FelipeSorrilha/Desenvolvimento-de-uma-plataforma-experimental/README.md

# Desenvolvimento-de-uma-plataforma-experimental
 Desenvolvimento de uma plataforma experimental para pesquisa em controle de sistemas aeroespaciais de asa rotativa utilizando impressão 3D
