FelipeSorrilha/Desenvolvimento-de-uma-plataforma-experimental/3D models/readme.md

# Modelos 3D

## helice

### Hélice que poderá ser utilizada junto com o Motor DC.

Inicialmente, será testado essa hélice com 2 pás.

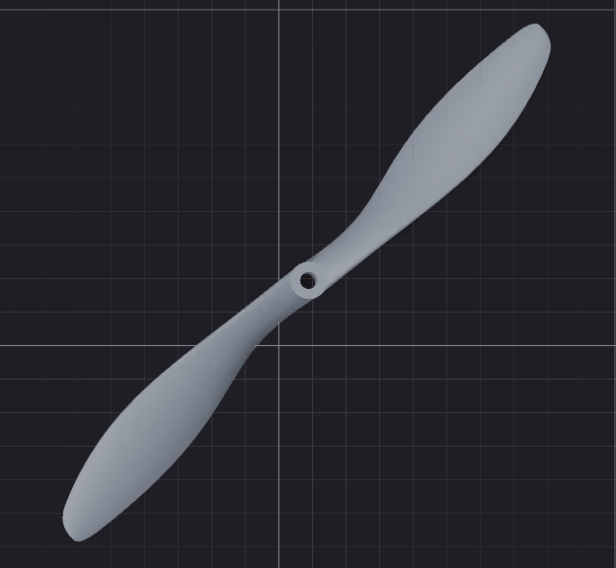
[picture p2: 3D models/imagens/helice.png]


---

## suporte-motor-drone

### Suporte onde o Motor DC 555-2990 vai ser encaixado.

O suporte foi projetado com uma abertura lateral e furos para os parafusos. Assim, o motor pode ser encaixado com facilidade, após apertar os parafusos, o suporte segura o motor.

Do outro lado, 5 furos foram posicionados para parafusar na peça encaixe-arm-motordrone. Os 5 parafusos em forma de cruz permitem que o suporte pode ser colocado tanto na vertical quanto na horizontal.

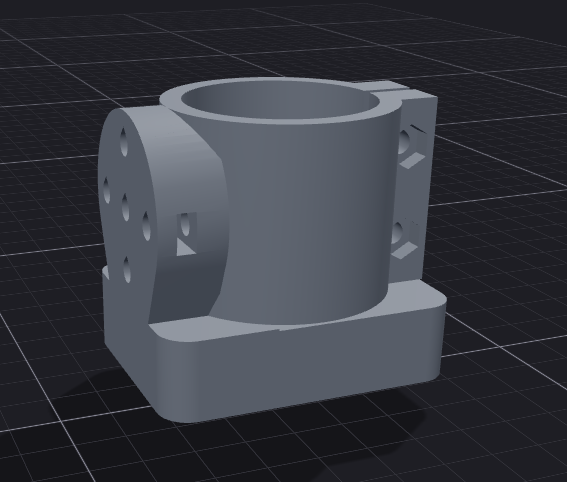
[picture p3: 3D models/imagens/suporte-motor-drone1.png]
Suporte motor drone


Em baixo do suporte, uma abertura foi feita para encaixar o encoder AS5047p.

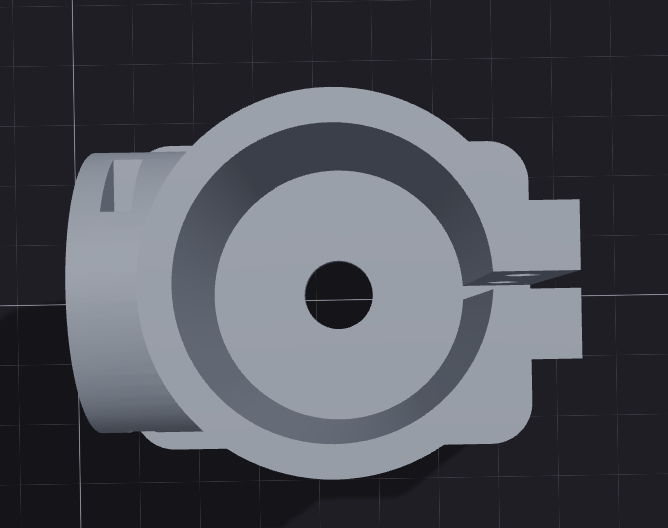
[picture p4: 3D models/imagens/suporte-motor-drone2.png]
Vista de cima


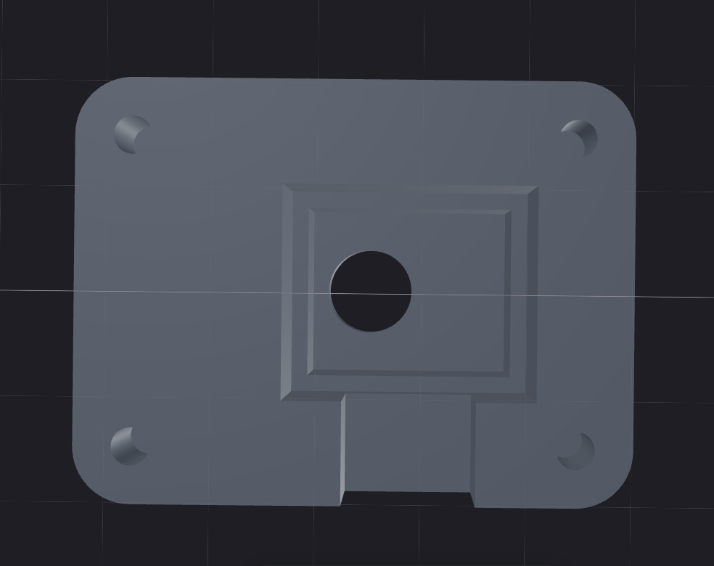
[picture p5: 3D models/imagens/suporte-motor-drone3.png]
Vista de baixo


---

## tampa-motor-drone

### Tampa para fechar e fixar o encoder em baixo do suporte do motor.

Essa tampa foi projetada para levantar um pouco a altura do encoder, deixando um pequeno espaço para os fios passarem.

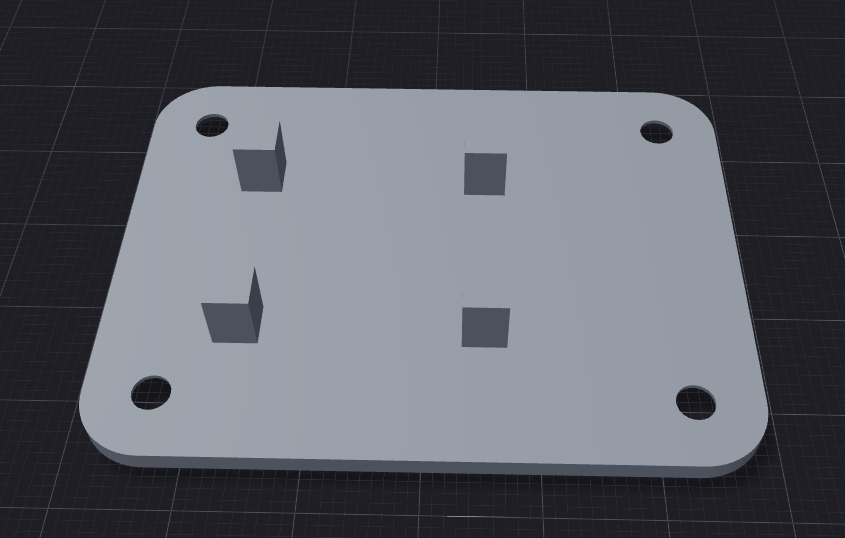
[picture p6: 3D models/imagens/tampa-motor-drone.png]
Tampa da peça anterior


---

## encaixe-arm-motordrone

### Encaixe que fixa o suporte do motor ao braço

Esse encaixe possui 3 furos que serão utilizados para fixar as duas peças.

Na horizontal, os outros 2 furos são utilizados para fixar o encaixe à peça arm.

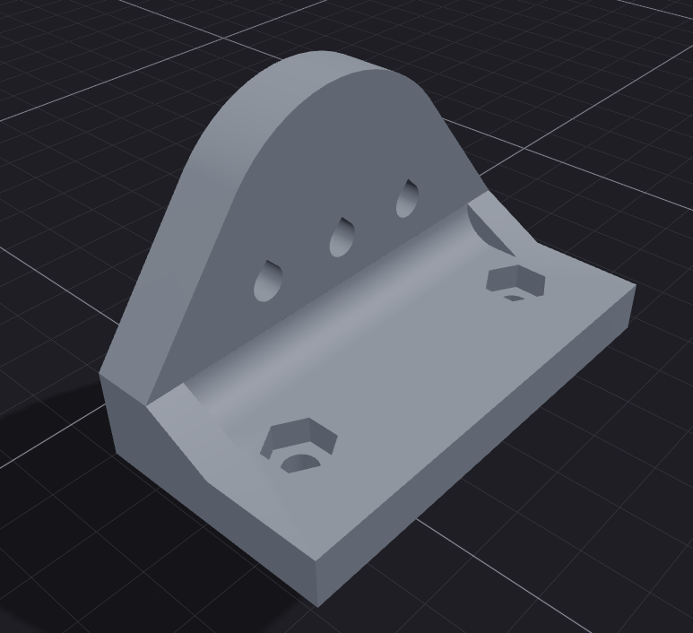
[picture p7: 3D models/imagens/encaixe-arm-motordrone.png]
Encaixe-arm-motordrone


---

## arm

### Braço que fixa a junção do suporte que segura o motor ao hub central.

Esse braço possui duas extremidades. A primeira com 2 furos é utilizada para fixar a peça encaixe-arm-motordrone, enquanto a outra extremidade com 4 furos é utilizada para fixar o braço ao hub central.

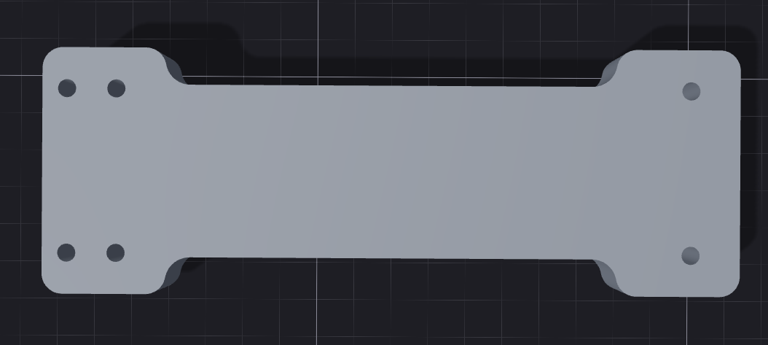
[picture p8: 3D models/imagens/arm.png]
Arm visto de cima


---

## central-hub

### Hub que fica no centro, tem espaço para o acelerômetro e segura os dois braços.

O furo no meio será utilizado para encaixar o eixo que será fixo e girará junto com os rolamentos. Enquanto isso, os 4 furos de cada lado são utilizados para fixar os braços

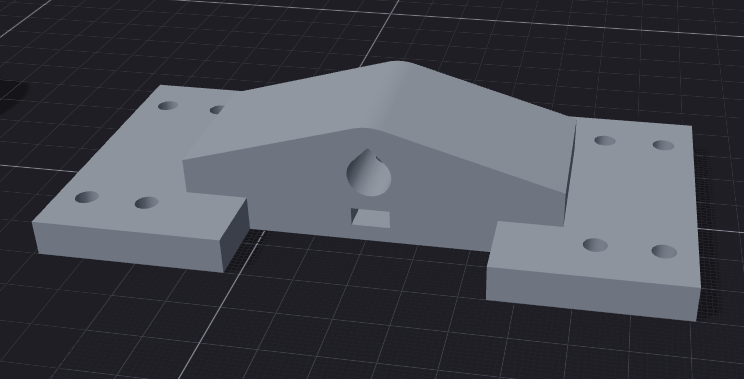
[picture p9: 3D models/imagens/central-hub1.png]
Hub central


Em baixo, há um espaço para encaixar o acelerômetro. 

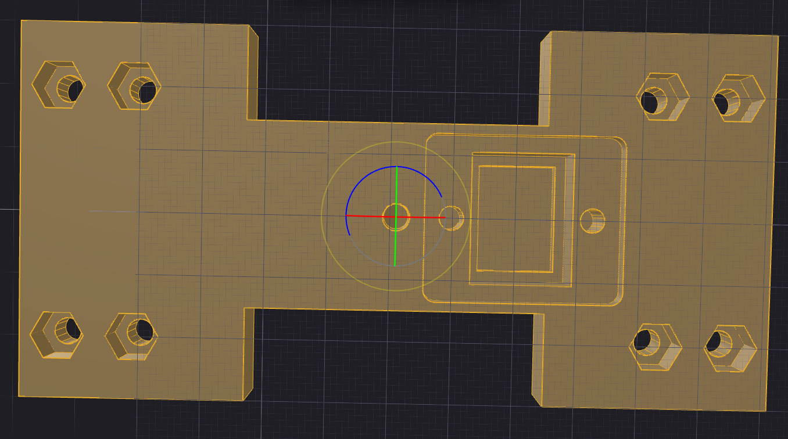
[picture p10: 3D models/imagens/central-hub2.png]
Vista de baixo com outra coloração para facilitar a visualização


---

## tampaCentralHub

### Tampa que fixa o acelerômetro em baixo do hub central.

Um pequeno suporte eleva a altura do acelerômetro. Alguns furos foram feitos para a passagem da fiação.

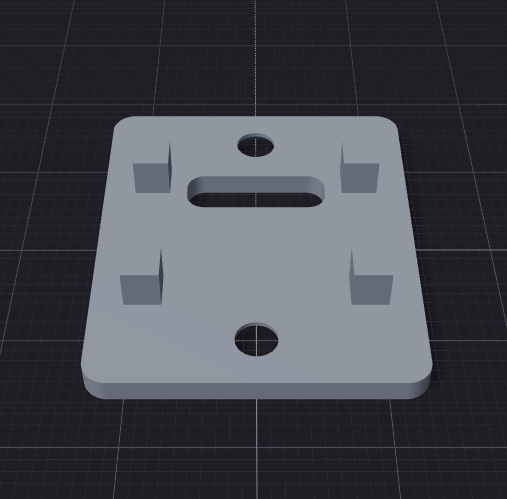
[picture p11: 3D models/imagens/tampaCentralHub.png]
Tampa do Hub Central


---

## Junção da primeira parte

### Formação da primeira parte, "gangorra".

Juntando as peças - suporte-motor-drone (2x), encaixe-arm-motordrone (2x), arm (2x) e central-hub - é possível visualizar a primeira parte da plataforma, que funciona como uma gangorra.

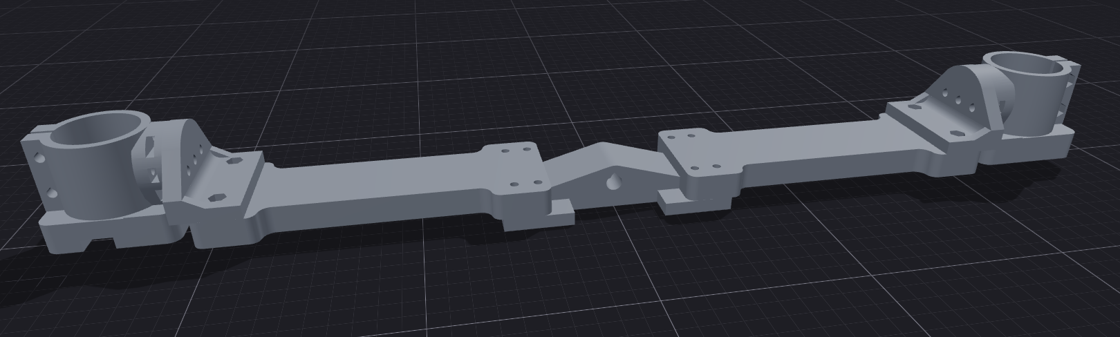
[picture p12: 3D models/imagens/encaixes1.png]


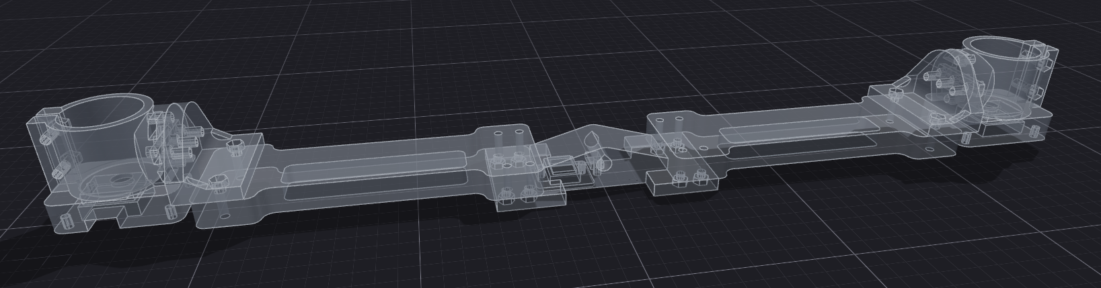
[picture p13: 3D models/imagens/encaixes2.png]
Outra visualização onde é possível ver os furos ligados


---

## novoTopo

### Topo do projeto, onde ficam os rolamentos e o eixo que segura o hub central.

De cada lado, um rolamento 608 será encaixado, enquanto um eixo irá atravessar eles e o hub central.

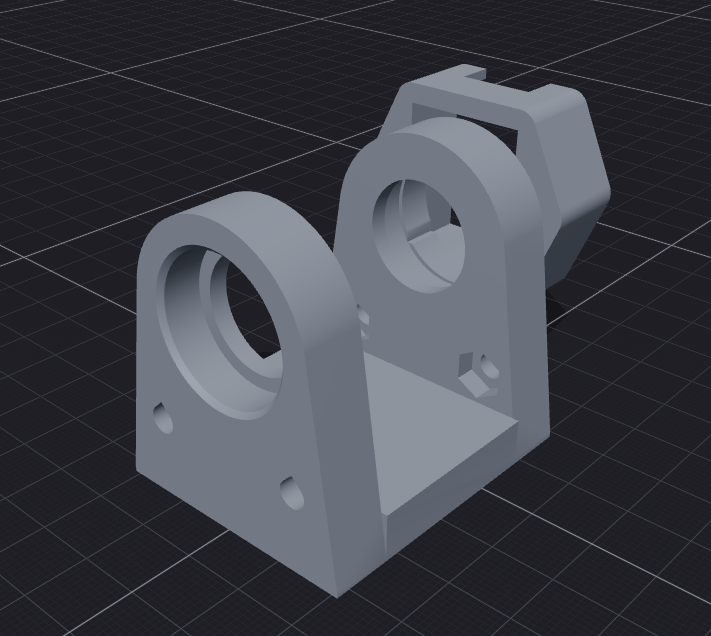
[picture p14: 3D models/imagens/novotopo1.png]


Em um dos lados, um encoder AS5047P será utilizado para medir a inclinação da "gangorra".

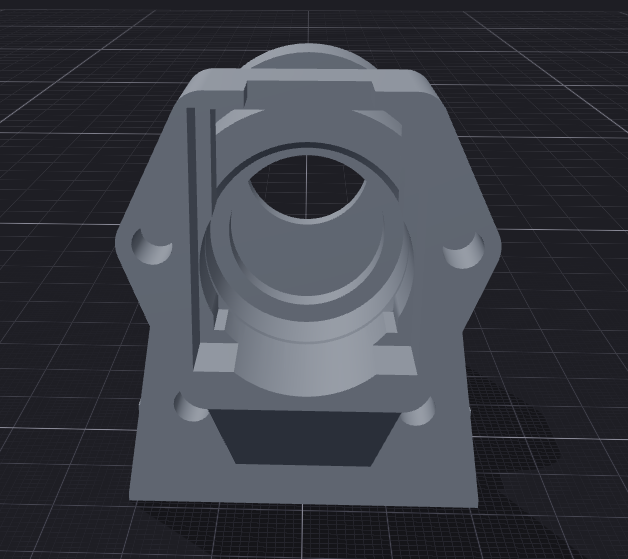
[picture p15: 3D models/imagens/novotopo2.png]


---

## tampaNovotopo

### Tampa que segura o encoder do novoTopo.

Uma tampa com pequenos suportes para deixar espaço para fiação irá prender o encoder AS5047p na lateral do novoTopo

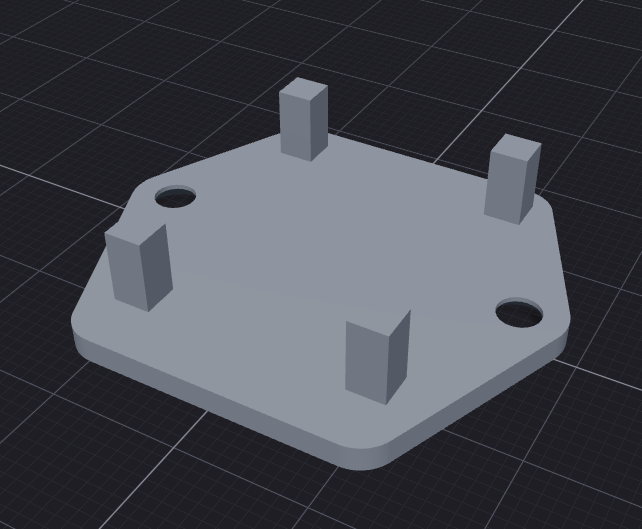
[picture p16: 3D models/imagens/tampaNovoTopo.png]


---

## eixoRolamentosEnconders

### Eixo que irá atravessar as peças.

Esse eixo girará junto com os rolamentos e será fixado no hub central. Em uma das extremidades, um imã será fixado para que o encoder possa medir a inclinação.

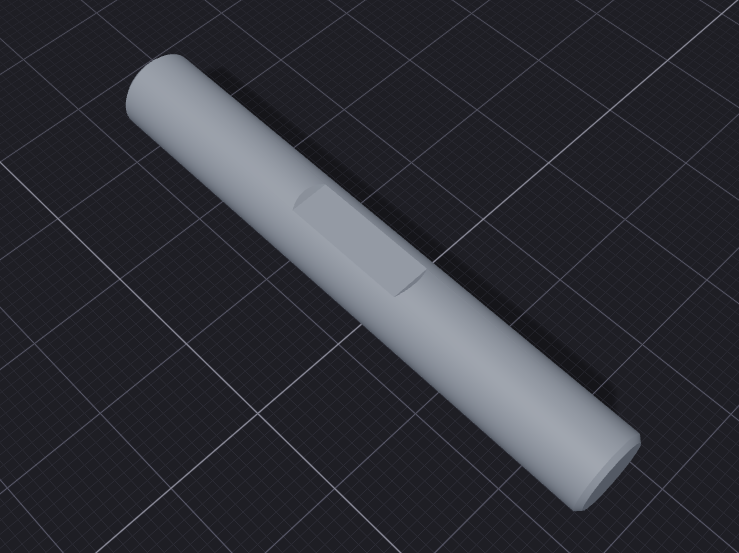
[picture p17: 3D models/imagens/eixoRolamentosEncoders.png]


---

## Y1 e Y2

### Duas peças que formam uma estrutura em formato de "Y".

Essas peças foram modeladas para que possam ser encaixadas e parafusadas.

Ela foi separada em duas peças para que fosse possível passar a fiação enquanto mantem esse formato de "Y". 

No topo dela, o novoTopo será fixado com parafusos. Em baixo, uma pequena parede será utilizada para limitar a rotação no plano XY. Um pequeno furo no centro será utilizado para fixar essa estrutura no encoder yaw que fica dentro da caixa.

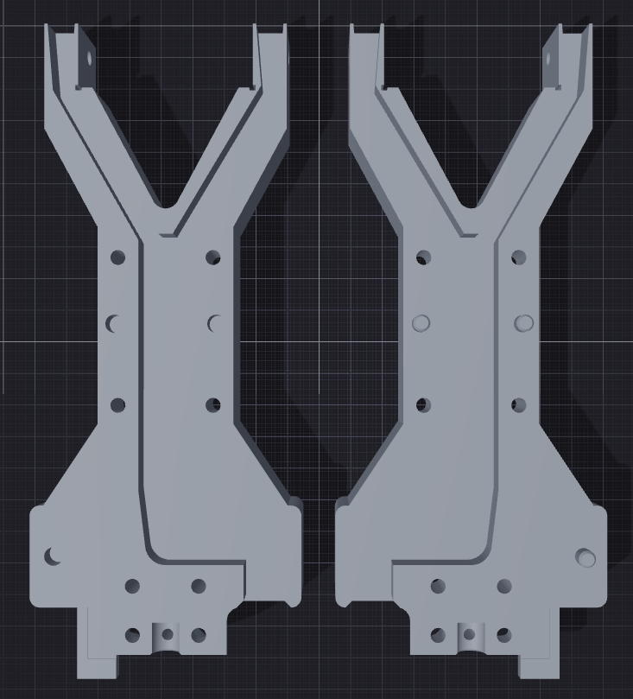
[picture p18: 3D models/imagens/y1ey2_1.png]


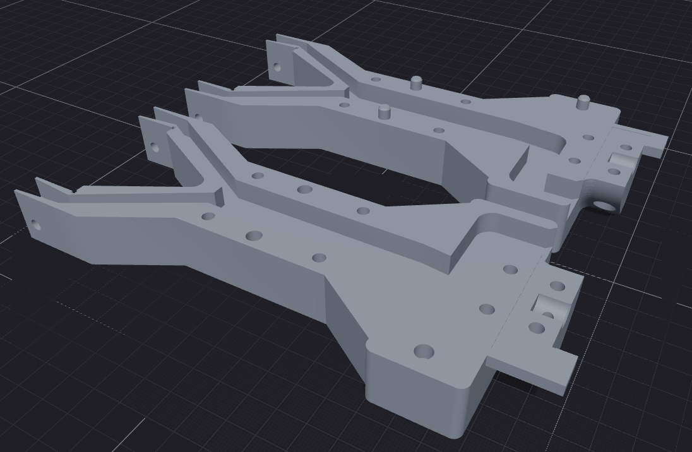
[picture p19: 3D models/imagens/y1ey2_2.png]


---

## Junção da segunda parte

### Formação da segunda parte em formato de "Y".

Juntando Y1, Y2, novoTopo e o eixoRolamentosEncoders, formamos a estrutura que sustentará a "gangorra", permitirá que ela possa se inclinar e poder girar 120° graus

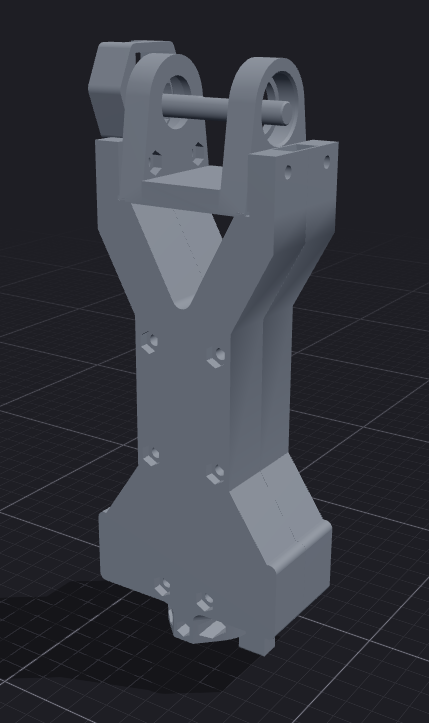
[picture p20: 3D models/imagens/encaixes3.png]


---

## Junção da primeira parte com a segunda

### Formação de tudo que ficará em cima da caixa.

Juntando todas essas peças, temos tudo que ficará em cima da caixa, que serve como base.

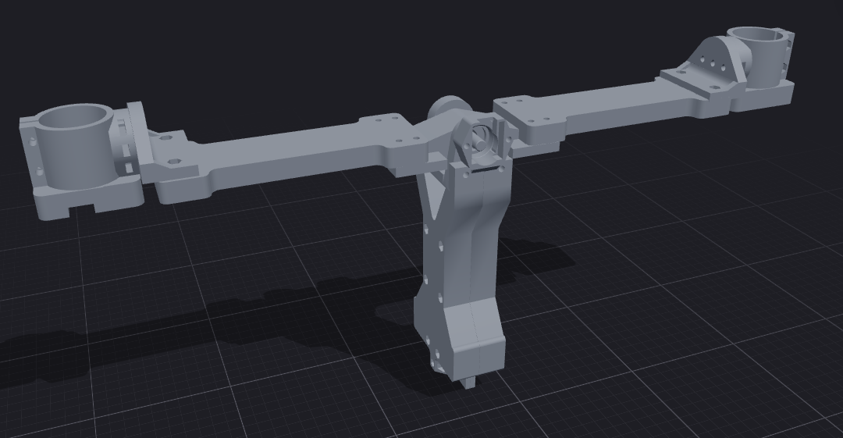
[picture p21: 3D models/imagens/parte1+2.png]


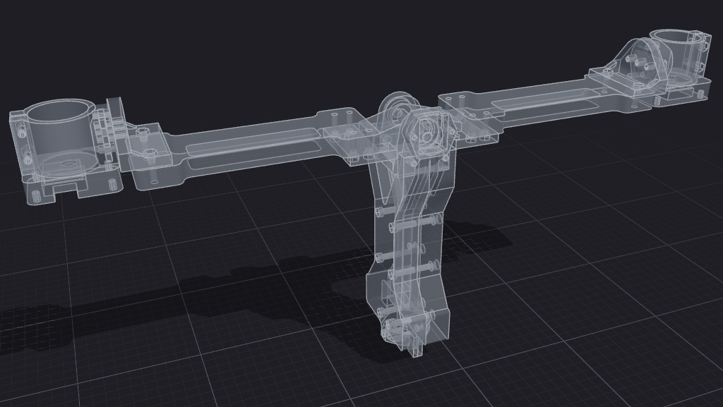
[picture p22: 3D models/imagens/parte1+2_2.png]


Do jeito que foi projetado, a "gangorra" (primeira parte) tem aproximadamente ±51,5° graus de liberdade, encostando no "Y" no máximo.

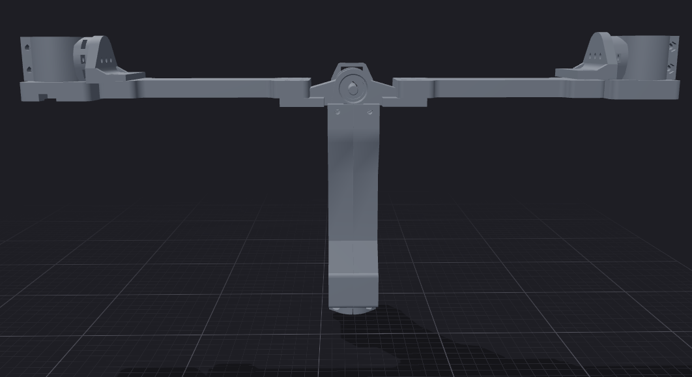
[picture p23: 3D models/imagens/parte1+2_3.png]


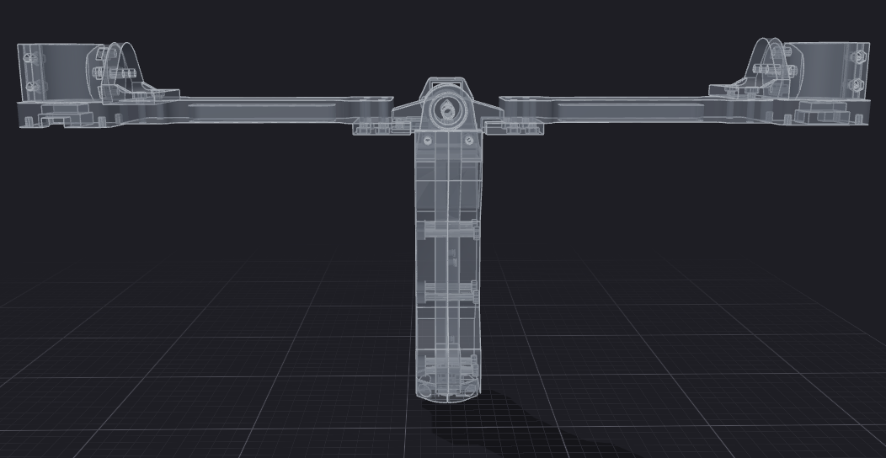
[picture p24: 3D models/imagens/parte1+2_4.png]


---

## caixav3

### Caixa onde fica o encoder de Yaw e microcontrolador.

A caixa (de ponta cabeça na foto) foi projetada para que o "Y" possa rotacionar aproximadamente 120 graus, enquanto deixa outros 120 graus para passagem de fiação.

No Centro, um cilindro com furos foi posicionado para poder fixar a peça RolamentoOldham-yaw. Peça qual conterá todo o dispositivo que permite o Y rotacionar.

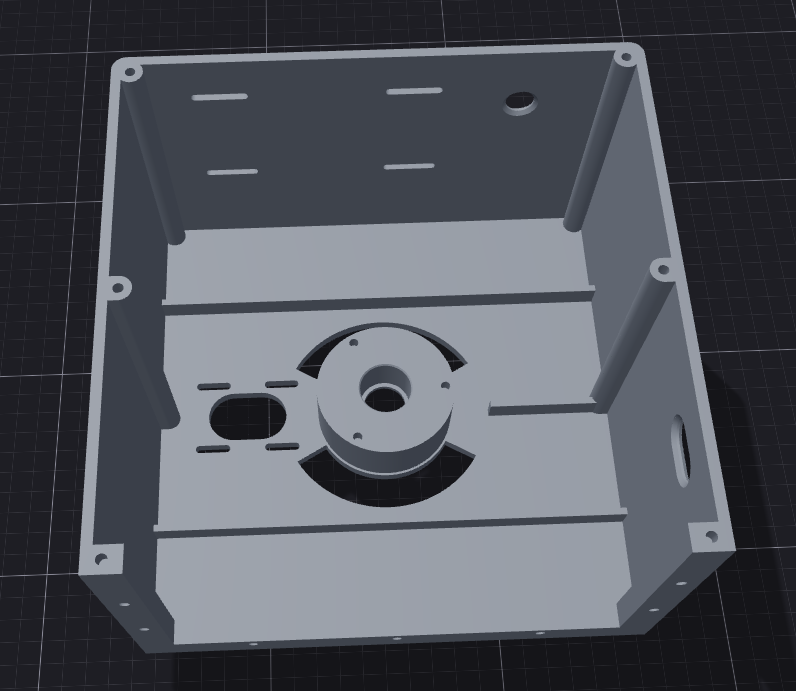
[picture p25: 3D models/imagens/caixav3_1.png]


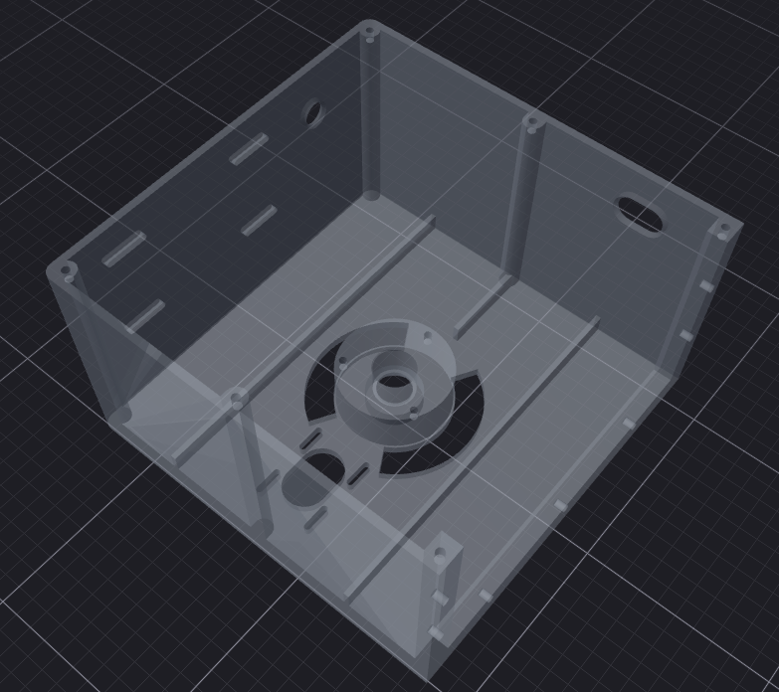
[picture p26: 3D models/imagens/caixav3_2.png]


Alguns furos foram feitos nas paredes para possibilitar a passagem de ar e passagem de cabos de alimentação.

---

## tampa-solo

### Tampa da caixa.

Uma tampa que, na verdade, fica em contato com o solo.

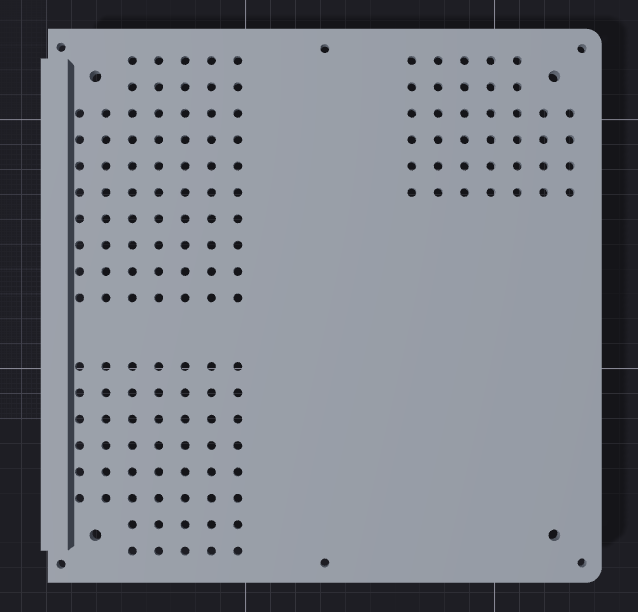
[picture p27: 3D models/imagens/tampa-solo.png]


---

## parede-removivel

### Parede da caixa.

Uma parede parafusada que pode ser retirada quando for preciso mudar algo no circuito. Para atualizar o microcontrolador (fazer upload de um novo código), basta passar o cabo por um dos furos da caixa.

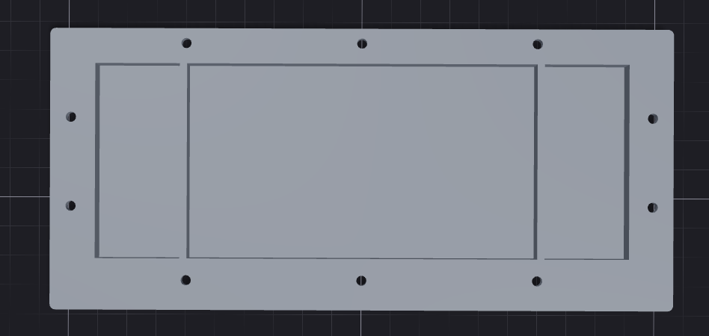
[picture p28: 3D models/imagens/paredeRemovivel.png]


---

## oldham1, oldham2, entreOsOldham

### Peças baseadas na junta oldham.

Três peças que foram baseadas na junta oldham. 

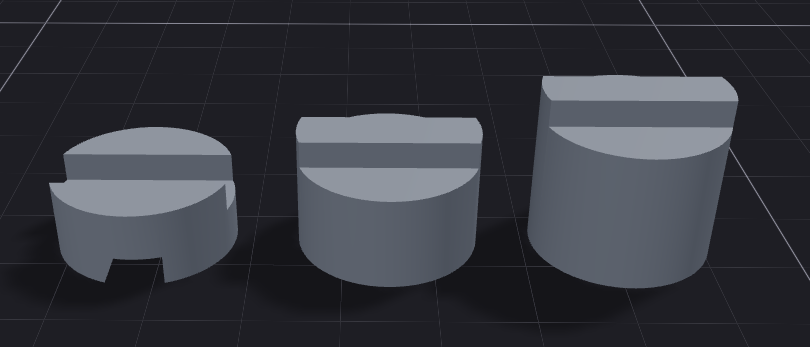
[picture p29: 3D models/imagens/oldham1.png]


A ideia é que um rolamento posicionado acima do encaixe faça toda a estrutura girar, que irá girar o eixo do encoder de Yaw posicionado em baixo.

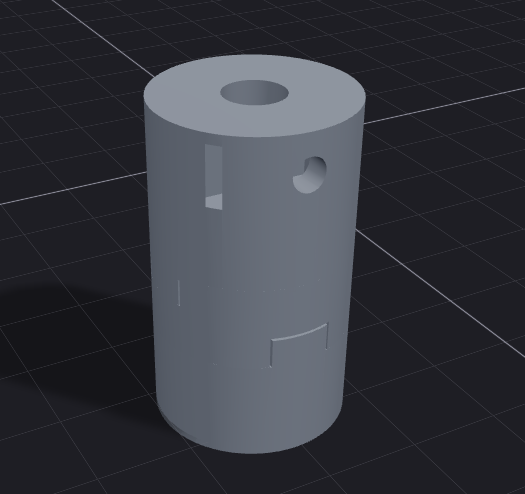
[picture p30: 3D models/imagens/oldhamjunto1.png]


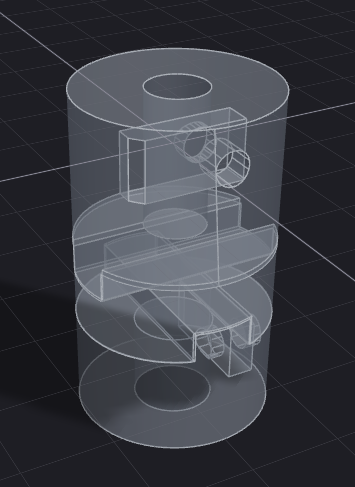
[picture p31: 3D models/imagens/oldhamjunto2.png]


---

## rolamentoToY

### Peça que gira o oldham.

É uma peça que é fixada no "Y", quando o Y gira, ela gira e movimento a junta oldham, que gira o encoder da base.

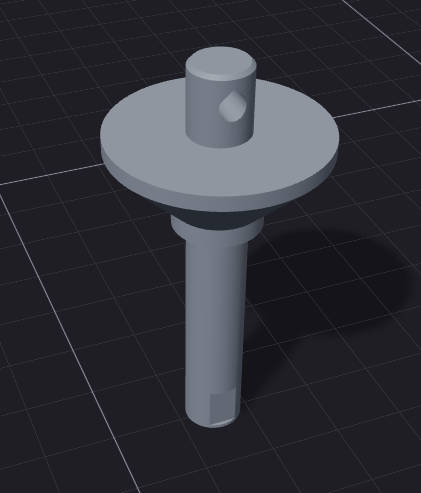
[picture p32: 3D models/imagens/rolamentoToY.png]


---

## RolamentoOldham-yaw

### Peça que é fixada no centro da caixa.

Dentro dessa peça, toda a junta oldham e o rolamento 608 serão posicionados para girar.

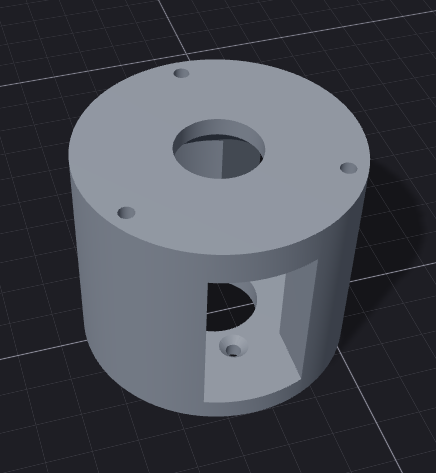
[picture p33: 3D models/imagens/rolamentooldham-yaw_1.png]


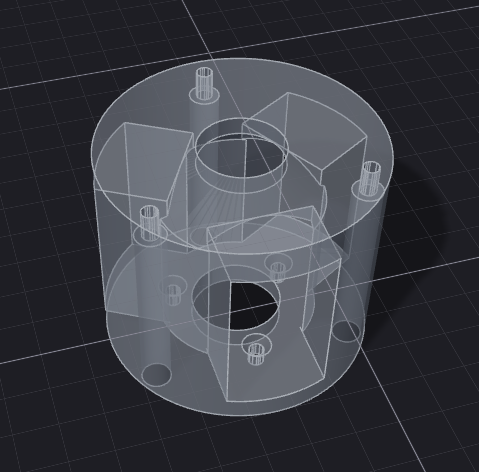
[picture p34: 3D models/imagens/rolamentooldham-yaw_2.png]


--- 

## Junção da terceira parte

### Encaixe da junta oldham na caixa.

Juntando a junta olhdam, RolamentoOldHam-yaw e rolamentoToY, temos a terceira parte que é encaixada na caixa.

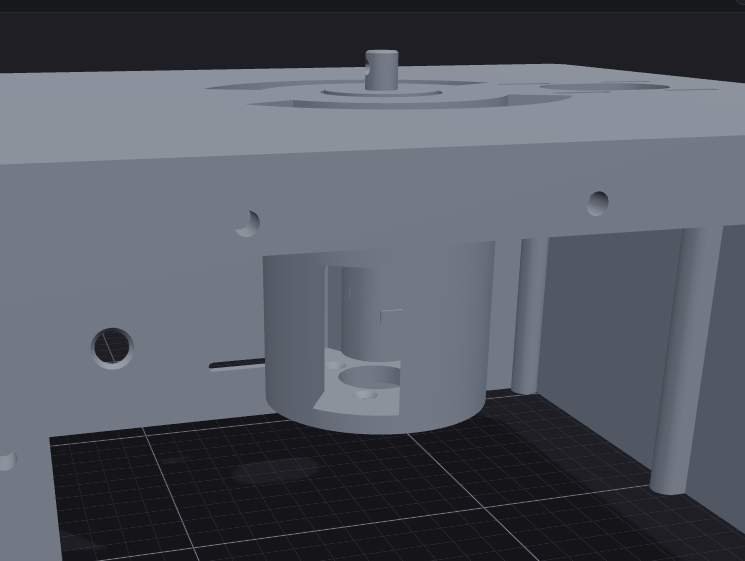
[picture p35: 3D models/imagens/oldhamInstaladoNaCaixa.png]


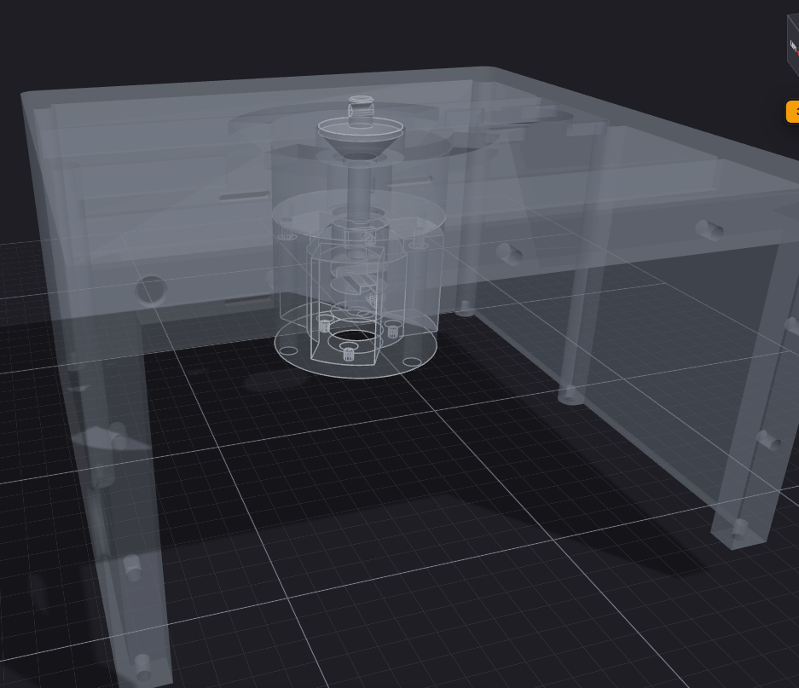
[picture p36: 3D models/imagens/oldhamInstaladoNaCaixa2.png]


--- 

## Junção da quarta parte

### Encaixe do Y na caixa, parede e tampa.

Fixando a tampa e parede removível, temos a caixa completa (na imagem, o motor em baixo é meramente ilustrativo)

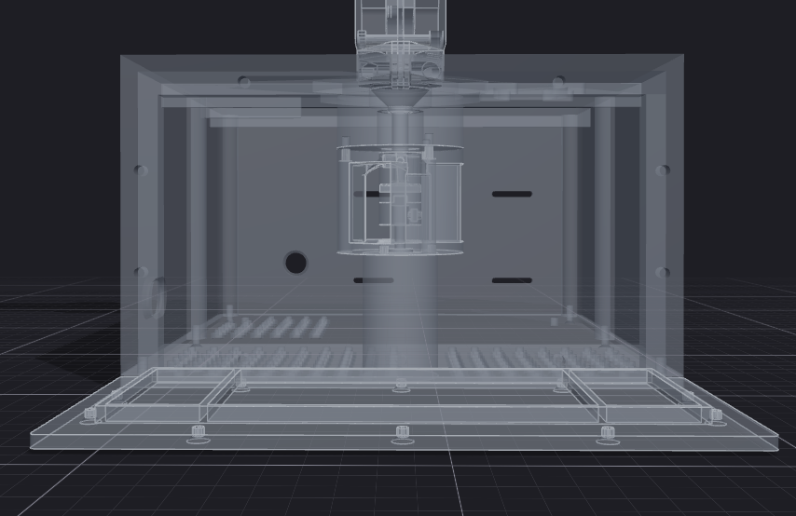
[picture p37: 3D models/imagens/montagemCompleta1_1.png]


Em cima da caixa, a parte 2 completa (Y) pode ser encaixada.

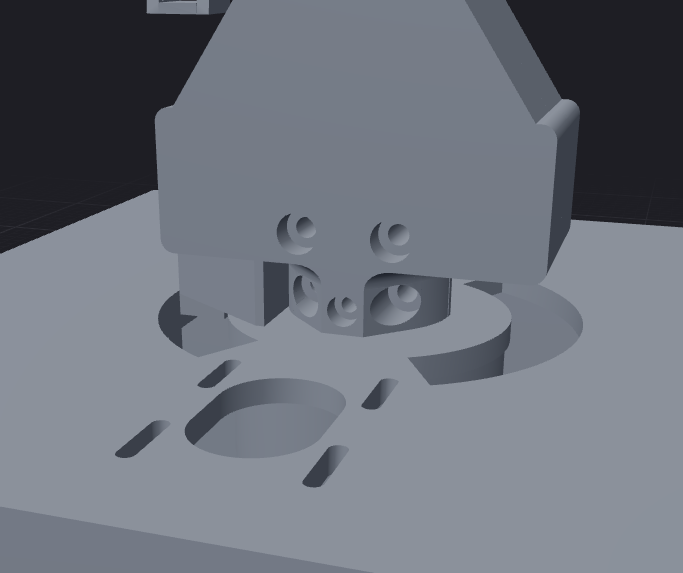
[picture p38: 3D models/imagens/encaixes4_1.png]


Desse jeito, a parede do Y fica encaixada com liberdade de se mover 120 graus, enquanto o outro espaço coincide com a passagem de fiação pelo Y.

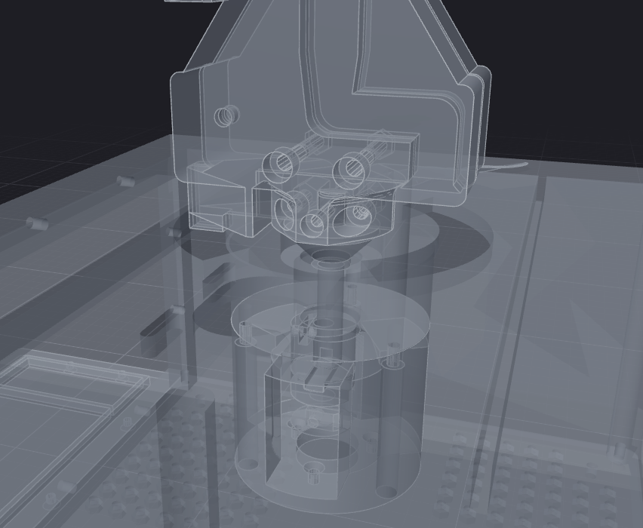
[picture p39: 3D models/imagens/encaixes4_2.png]


--- 

## Montagem completa

### Montagem completa usando o modelo 3D de um motor no lugar do encoder de yaw e motores das hélices

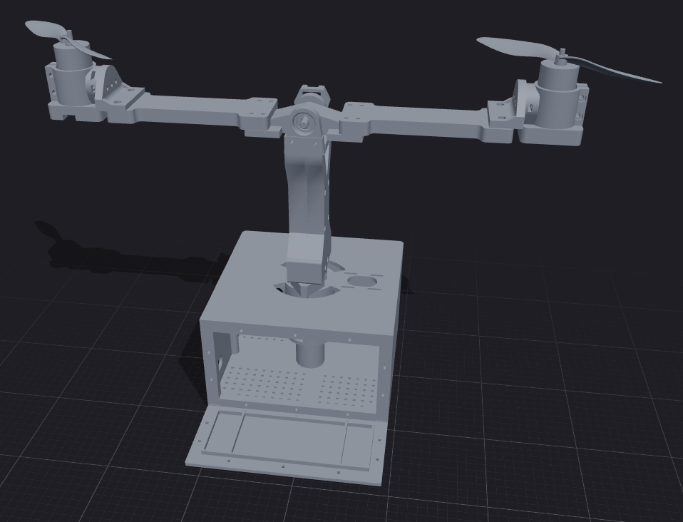
[picture p40: 3D models/imagens/montagemCompleta1.png]


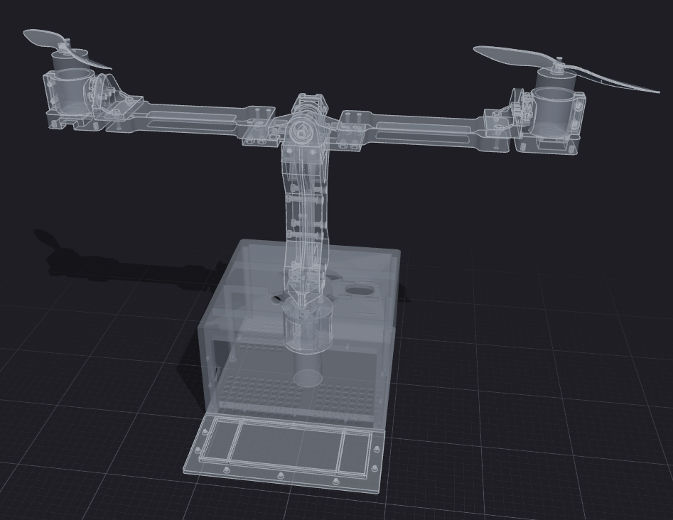
[picture p41: 3D models/imagens/montagemCompleta2.png]


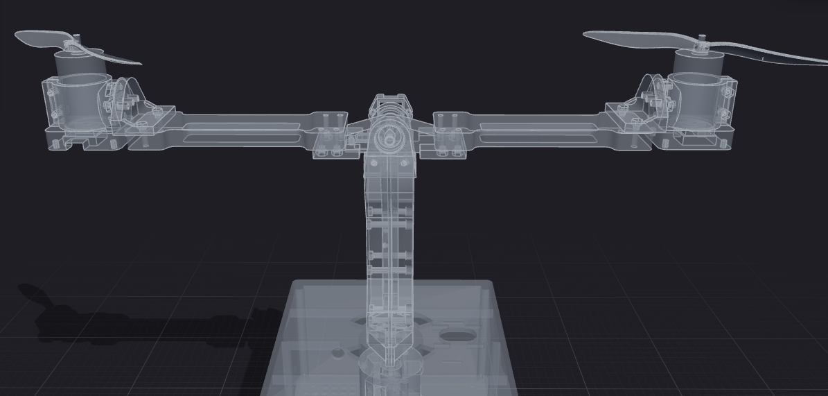
[picture p42: 3D models/imagens/montagemCompleta1_2.png]
