FelipeSorrilha/Desenvolvimento-de-uma-plataforma-experimental/3D models/arquivos-stl/tampa-motor-drone-v2.stl

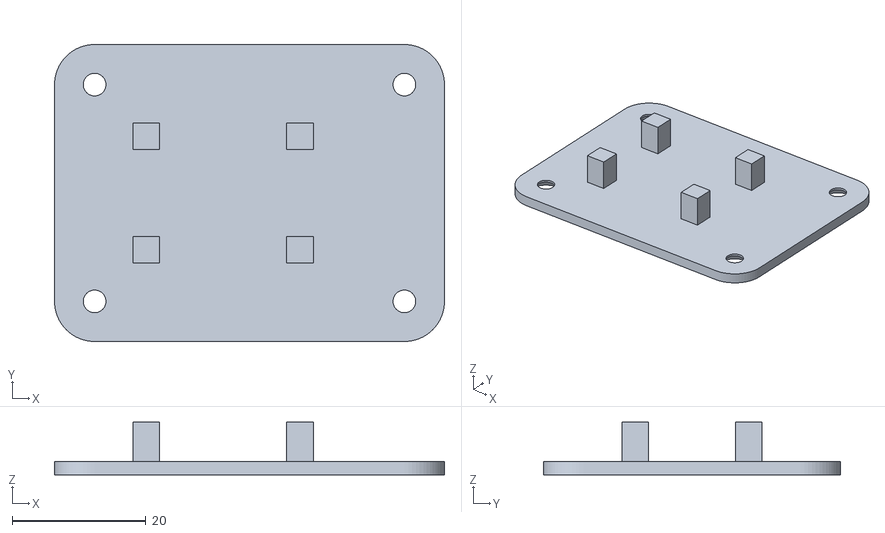
[picture p43: CAD file, 2026-11-11]
3D models/arquivos-stl/tampa-motor-drone-v2.stl
58.3 x 44.4 x 7.90
