FelipeSorrilha/Desenvolvimento-de-uma-plataforma-experimental/simulacao_matlab/stl/helice.stl

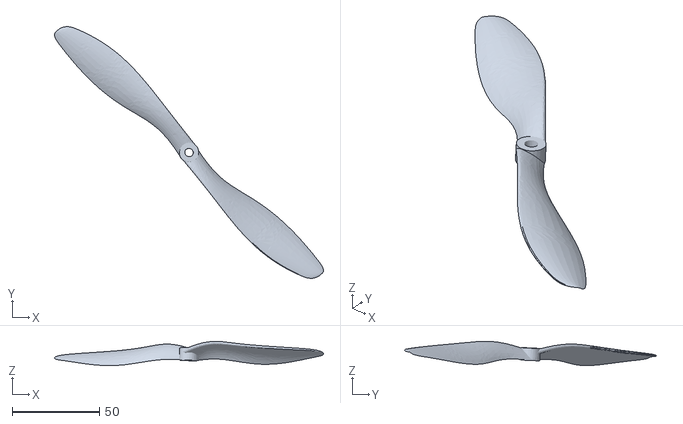
[picture p44: CAD file, 2026-10-20]
simulacao_matlab/stl/helice.stl
154.2 x 144.3 x 13.9
