FelipeSorrilha/Desenvolvimento-de-uma-plataforma-experimental/3D models/arquivos-stl/suporte-motor-drone-v3.stl

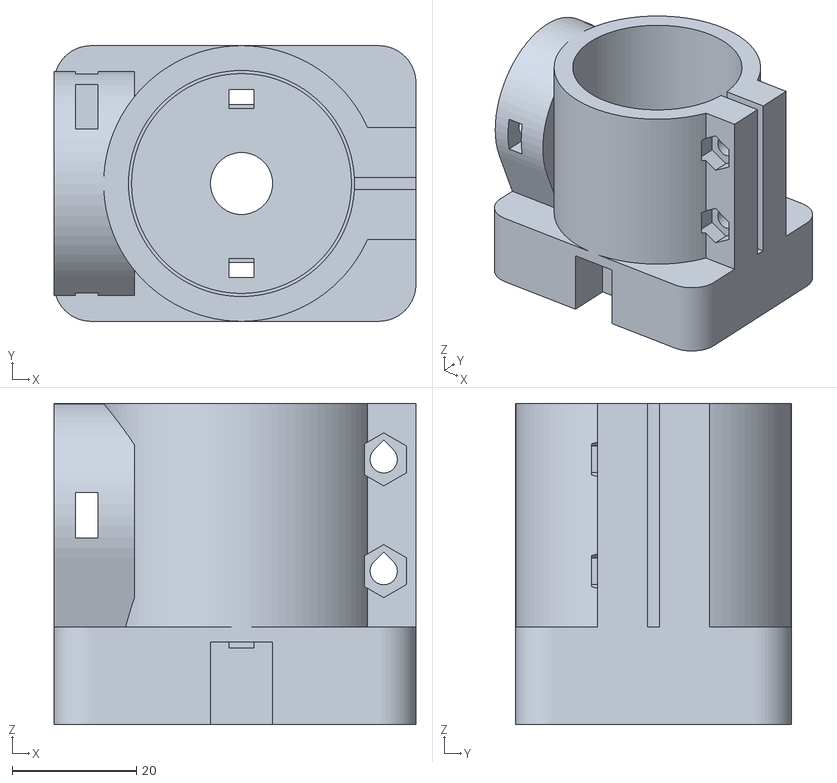
[picture p45: CAD file, 2026-11-11]
3D models/arquivos-stl/suporte-motor-drone-v3.stl
58.3 x 44.4 x 51.7
