FelipeSorrilha/Desenvolvimento-de-uma-plataforma-experimental/simulacao_matlab/stl/rolamentoToY.stl

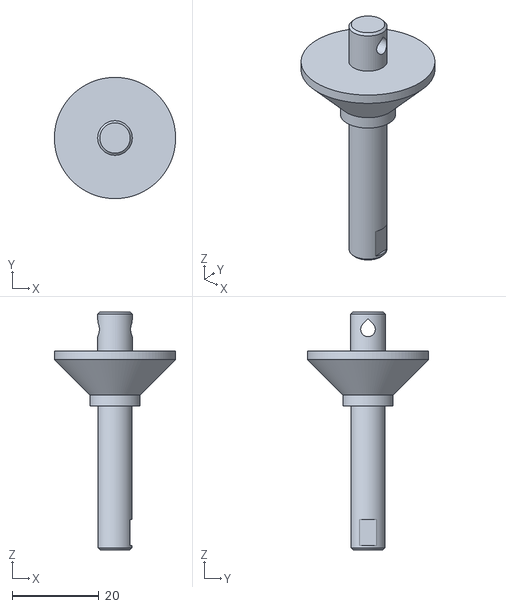
[picture p46: CAD file, 2026-10-20]
simulacao_matlab/stl/rolamentoToY.stl
28.0 x 28.0 x 55.0
