FelipeSorrilha/Desenvolvimento-de-uma-plataforma-experimental/simulacao_matlab/stl/caixav3.stl

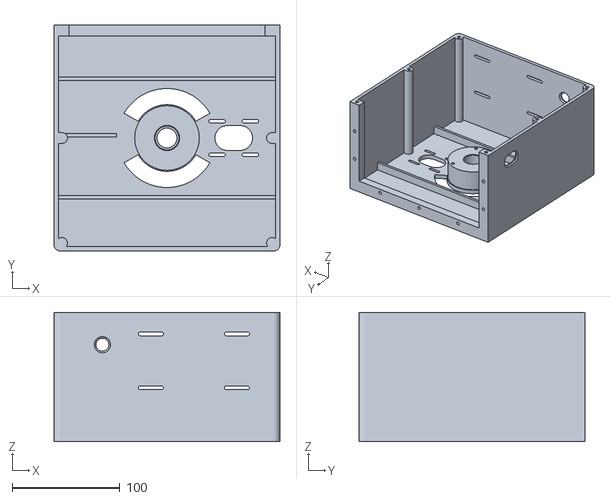
[picture p47: CAD file, 2026-10-20]
simulacao_matlab/stl/caixav3.stl
210.0 x 210.0 x 120.0
