FelipeSorrilha/Desenvolvimento-de-uma-plataforma-experimental/simulacao_matlab/stl/oldham1.stl

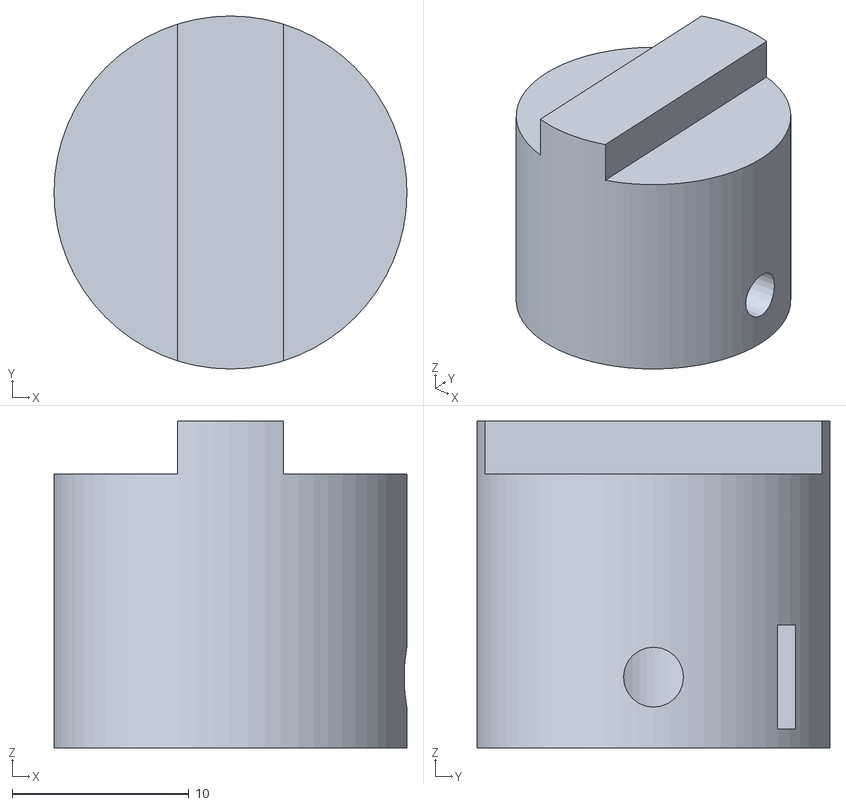
[picture p48: CAD file, 2026-10-20]
simulacao_matlab/stl/oldham1.stl
20.0 x 20.0 x 18.5
