FelipeSorrilha/Desenvolvimento-de-uma-plataforma-experimental/simulacao_matlab/stl/oldham2.stl

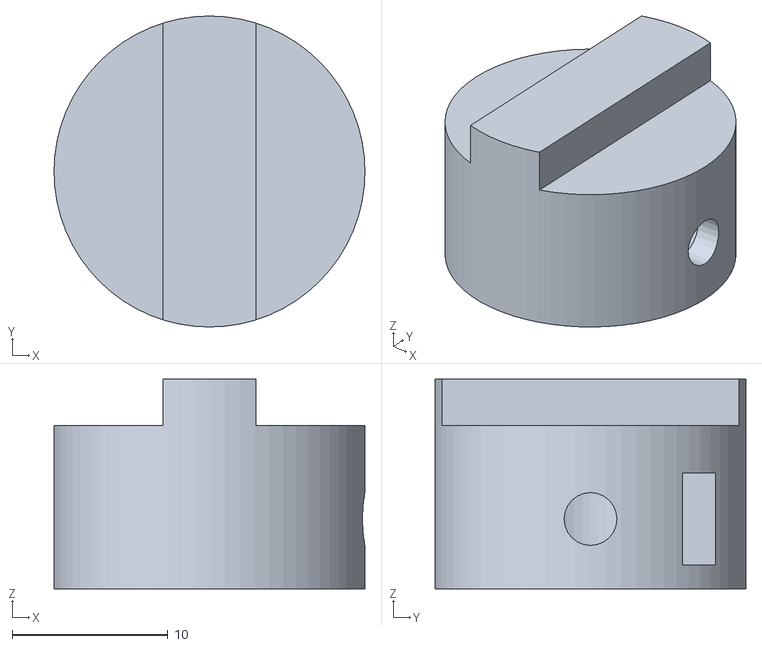
[picture p49: CAD file, 2026-10-20]
simulacao_matlab/stl/oldham2.stl
20.0 x 20.0 x 13.5
