FelipeSorrilha/Desenvolvimento-de-uma-plataforma-experimental/simulacao_matlab/stl/y2v2.stl

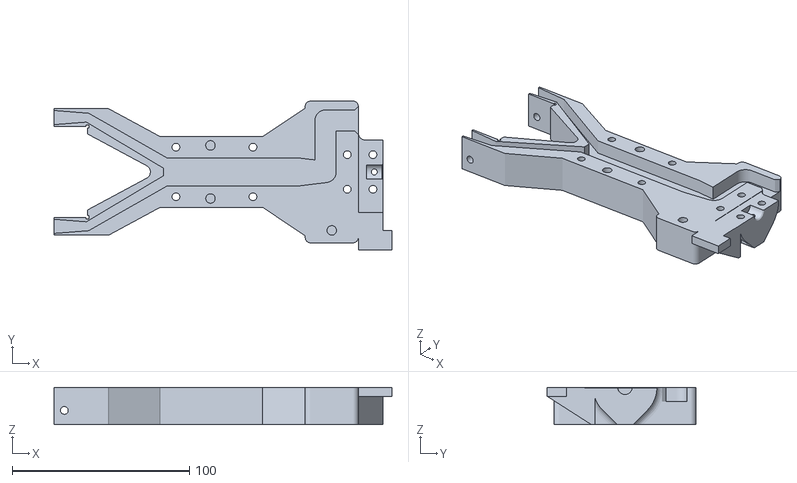
[picture p50: CAD file, 2026-10-20]
simulacao_matlab/stl/y2v2.stl
190.8 x 84.0 x 21.0
