FelipeSorrilha/Desenvolvimento-de-uma-plataforma-experimental/simulacao_matlab/stl/parede-removivel.stl

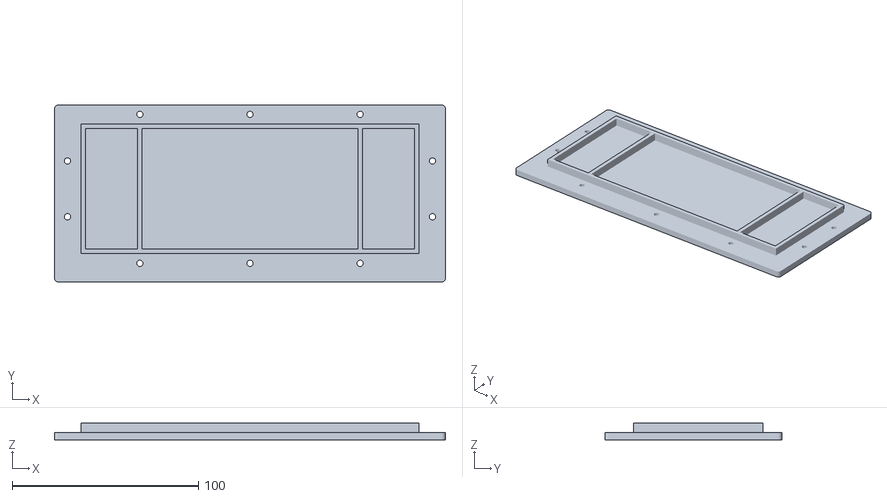
[picture p51: CAD file, 2026-10-20]
simulacao_matlab/stl/parede-removivel.stl
210.0 x 95.0 x 9.00
