FelipeSorrilha/Desenvolvimento-de-uma-plataforma-experimental/simulacao_matlab/stl/entreOsOldham.stl

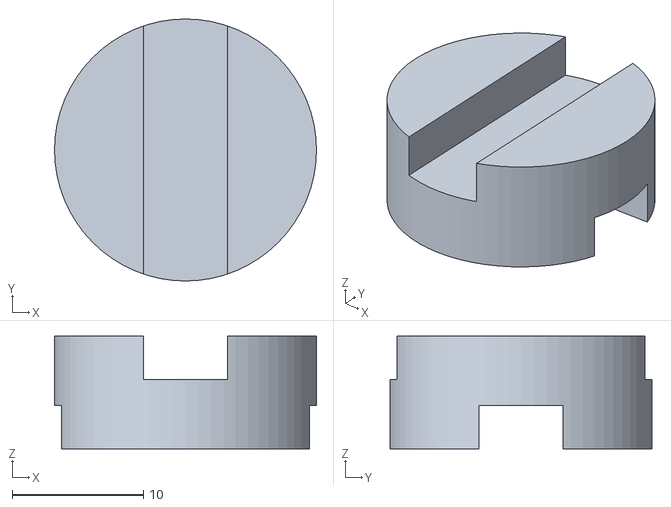
[picture p52: CAD file, 2026-10-20]
simulacao_matlab/stl/entreOsOldham.stl
20.0 x 20.0 x 8.60
