FelipeSorrilha/Desenvolvimento-de-uma-plataforma-experimental/simulacao_matlab/stl/RolamentoOldham-yaw.stl

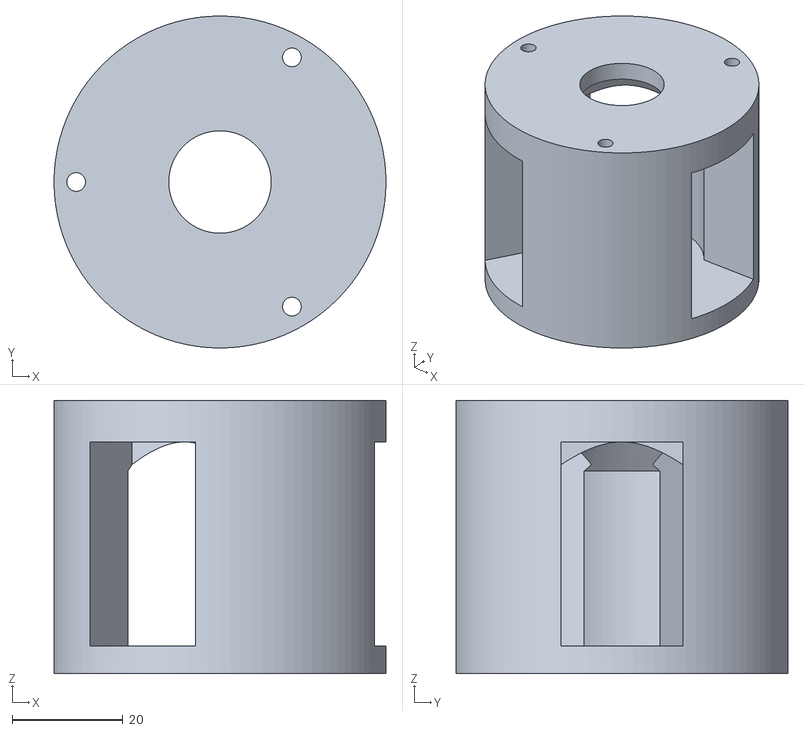
[picture p53: CAD file, 2026-10-20]
simulacao_matlab/stl/RolamentoOldham-yaw.stl
60.0 x 60.0 x 49.3
