FelipeSorrilha/Desenvolvimento-de-uma-plataforma-experimental/simulacao_matlab/stl/tampa-solo.stl

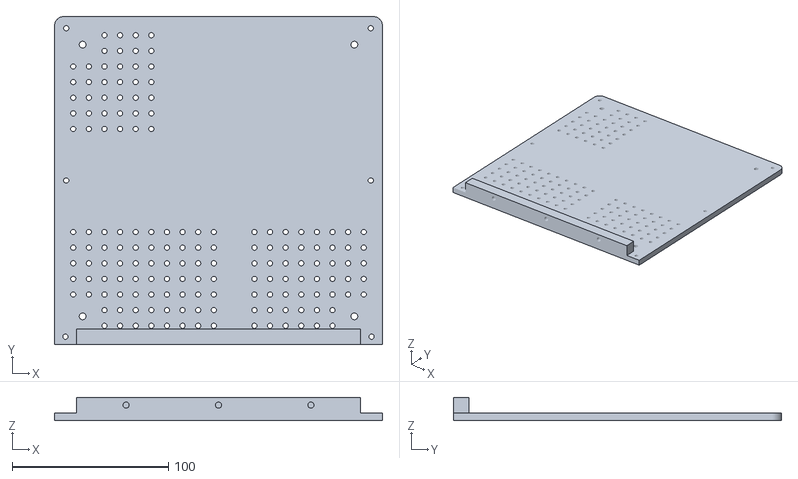
[picture p54: CAD file, 2026-10-20]
simulacao_matlab/stl/tampa-solo.stl
210.0 x 210.0 x 15.0
