FelipeSorrilha/Desenvolvimento-de-uma-plataforma-experimental/simulacao_matlab/stl/tampaNovoTopo.stl

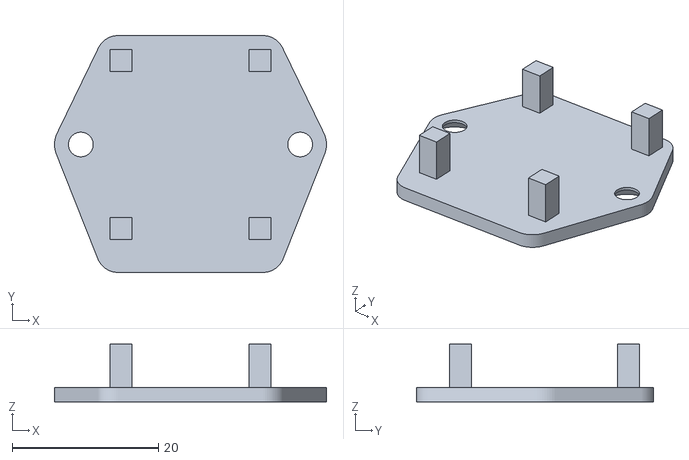
[picture p56: CAD file, 2026-10-15]
simulacao_matlab/stl/tampaNovoTopo.stl
37.2 x 32.4 x 7.90
