FelipeSorrilha/Desenvolvimento-de-uma-plataforma-experimental/simulacao_matlab/stl/eixoRolamentosEncoders.stl

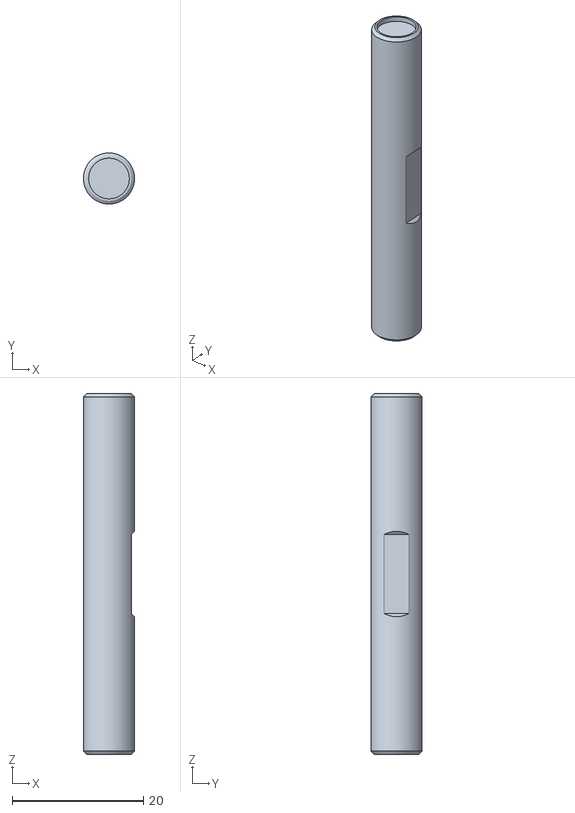
[picture p57: CAD file, 2026-10-15]
simulacao_matlab/stl/eixoRolamentosEncoders.stl
7.80 x 7.80 x 55.0
