FelipeSorrilha/Desenvolvimento-de-uma-plataforma-experimental/simulacao_matlab/stl/novoTopo.stl

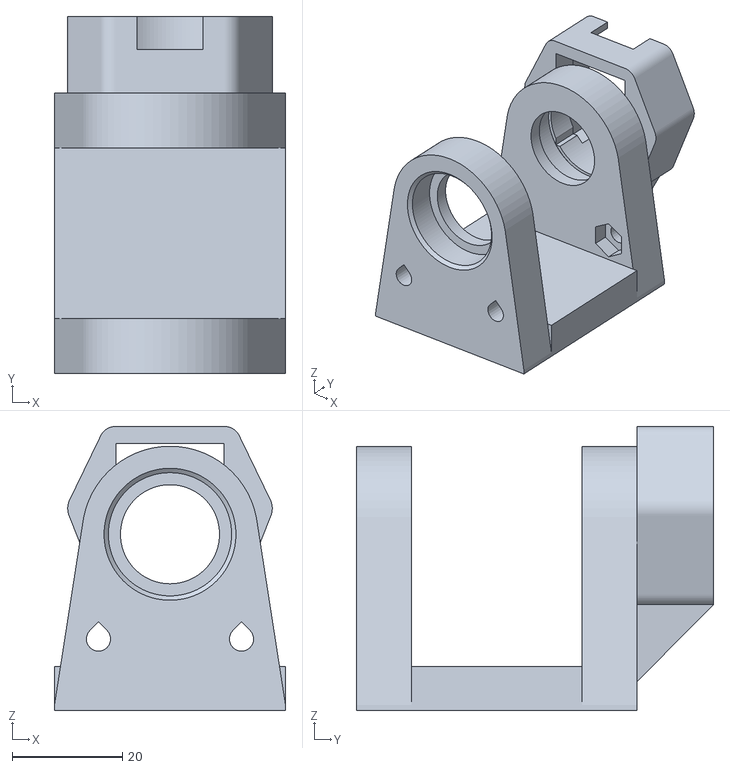
[picture p58: CAD file, 2026-10-15]
simulacao_matlab/stl/novoTopo.stl
42.0 x 64.9 x 51.6
