FelipeSorrilha/Desenvolvimento-de-uma-plataforma-experimental/simulacao_matlab/stl/tampaCentralHub.stl

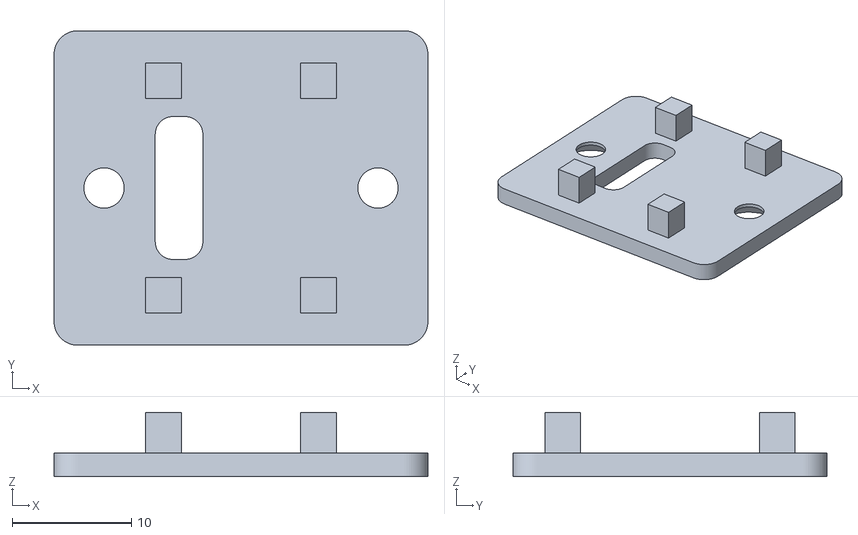
[picture p59: CAD file, 2026-10-15]
simulacao_matlab/stl/tampaCentralHub.stl
31.4 x 26.4 x 5.40
