FelipeSorrilha/Desenvolvimento-de-uma-plataforma-experimental/simulacao_matlab/stl/centralhubv2.stl

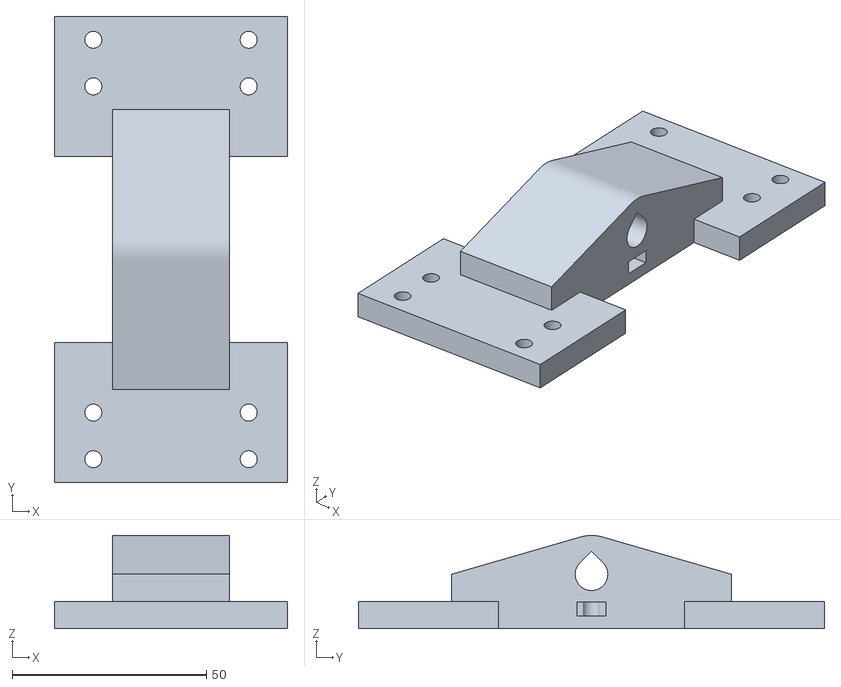
[picture p60: CAD file, 2026-10-15]
simulacao_matlab/stl/centralhubv2.stl
60.0 x 120.0 x 24.0
