FelipeSorrilha/Desenvolvimento-de-uma-plataforma-experimental/simulacao_matlab/stl/encaixe-arm-motordrone.stl

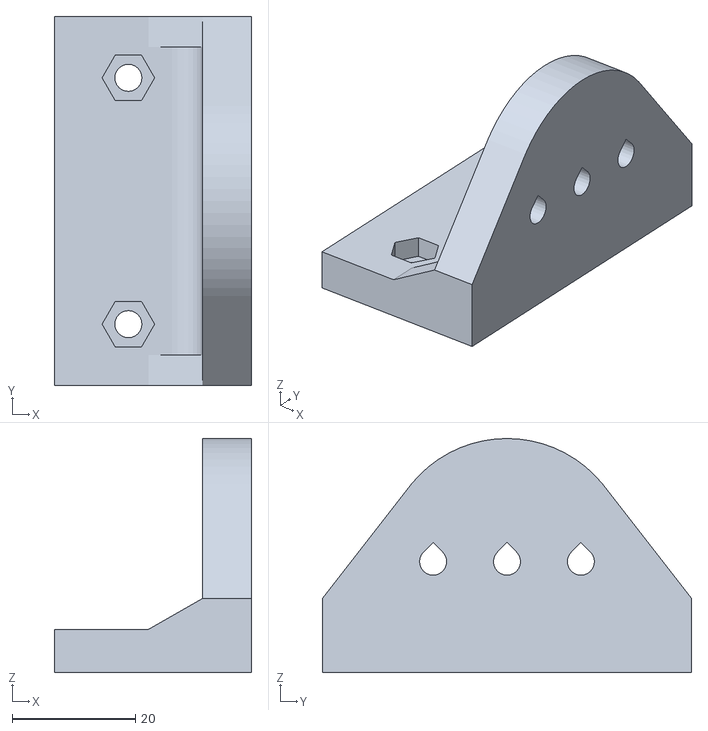
[picture p61: CAD file, 2026-10-15]
simulacao_matlab/stl/encaixe-arm-motordrone.stl
32.0 x 60.0 x 38.0
