FelipeSorrilha/Desenvolvimento-de-uma-plataforma-experimental/simulacao_matlab/stl/arm.stl

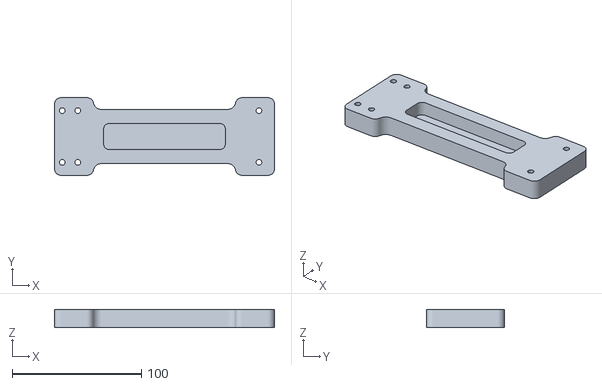
[picture p62: CAD file, 2026-10-15]
simulacao_matlab/stl/arm.stl
170.0 x 60.0 x 14.0
