FelipeSorrilha/Desenvolvimento-de-uma-plataforma-experimental/(list of files, cad)

Other CAD files:
simulacao_matlab/stl/tampa-motor-drone.stl
simulacao_matlab/stl/suporte-motor-drone.stl
