FelipeSorrilha/Desenvolvimento-de-uma-plataforma-experimental/3D models/2D/arm.pdf

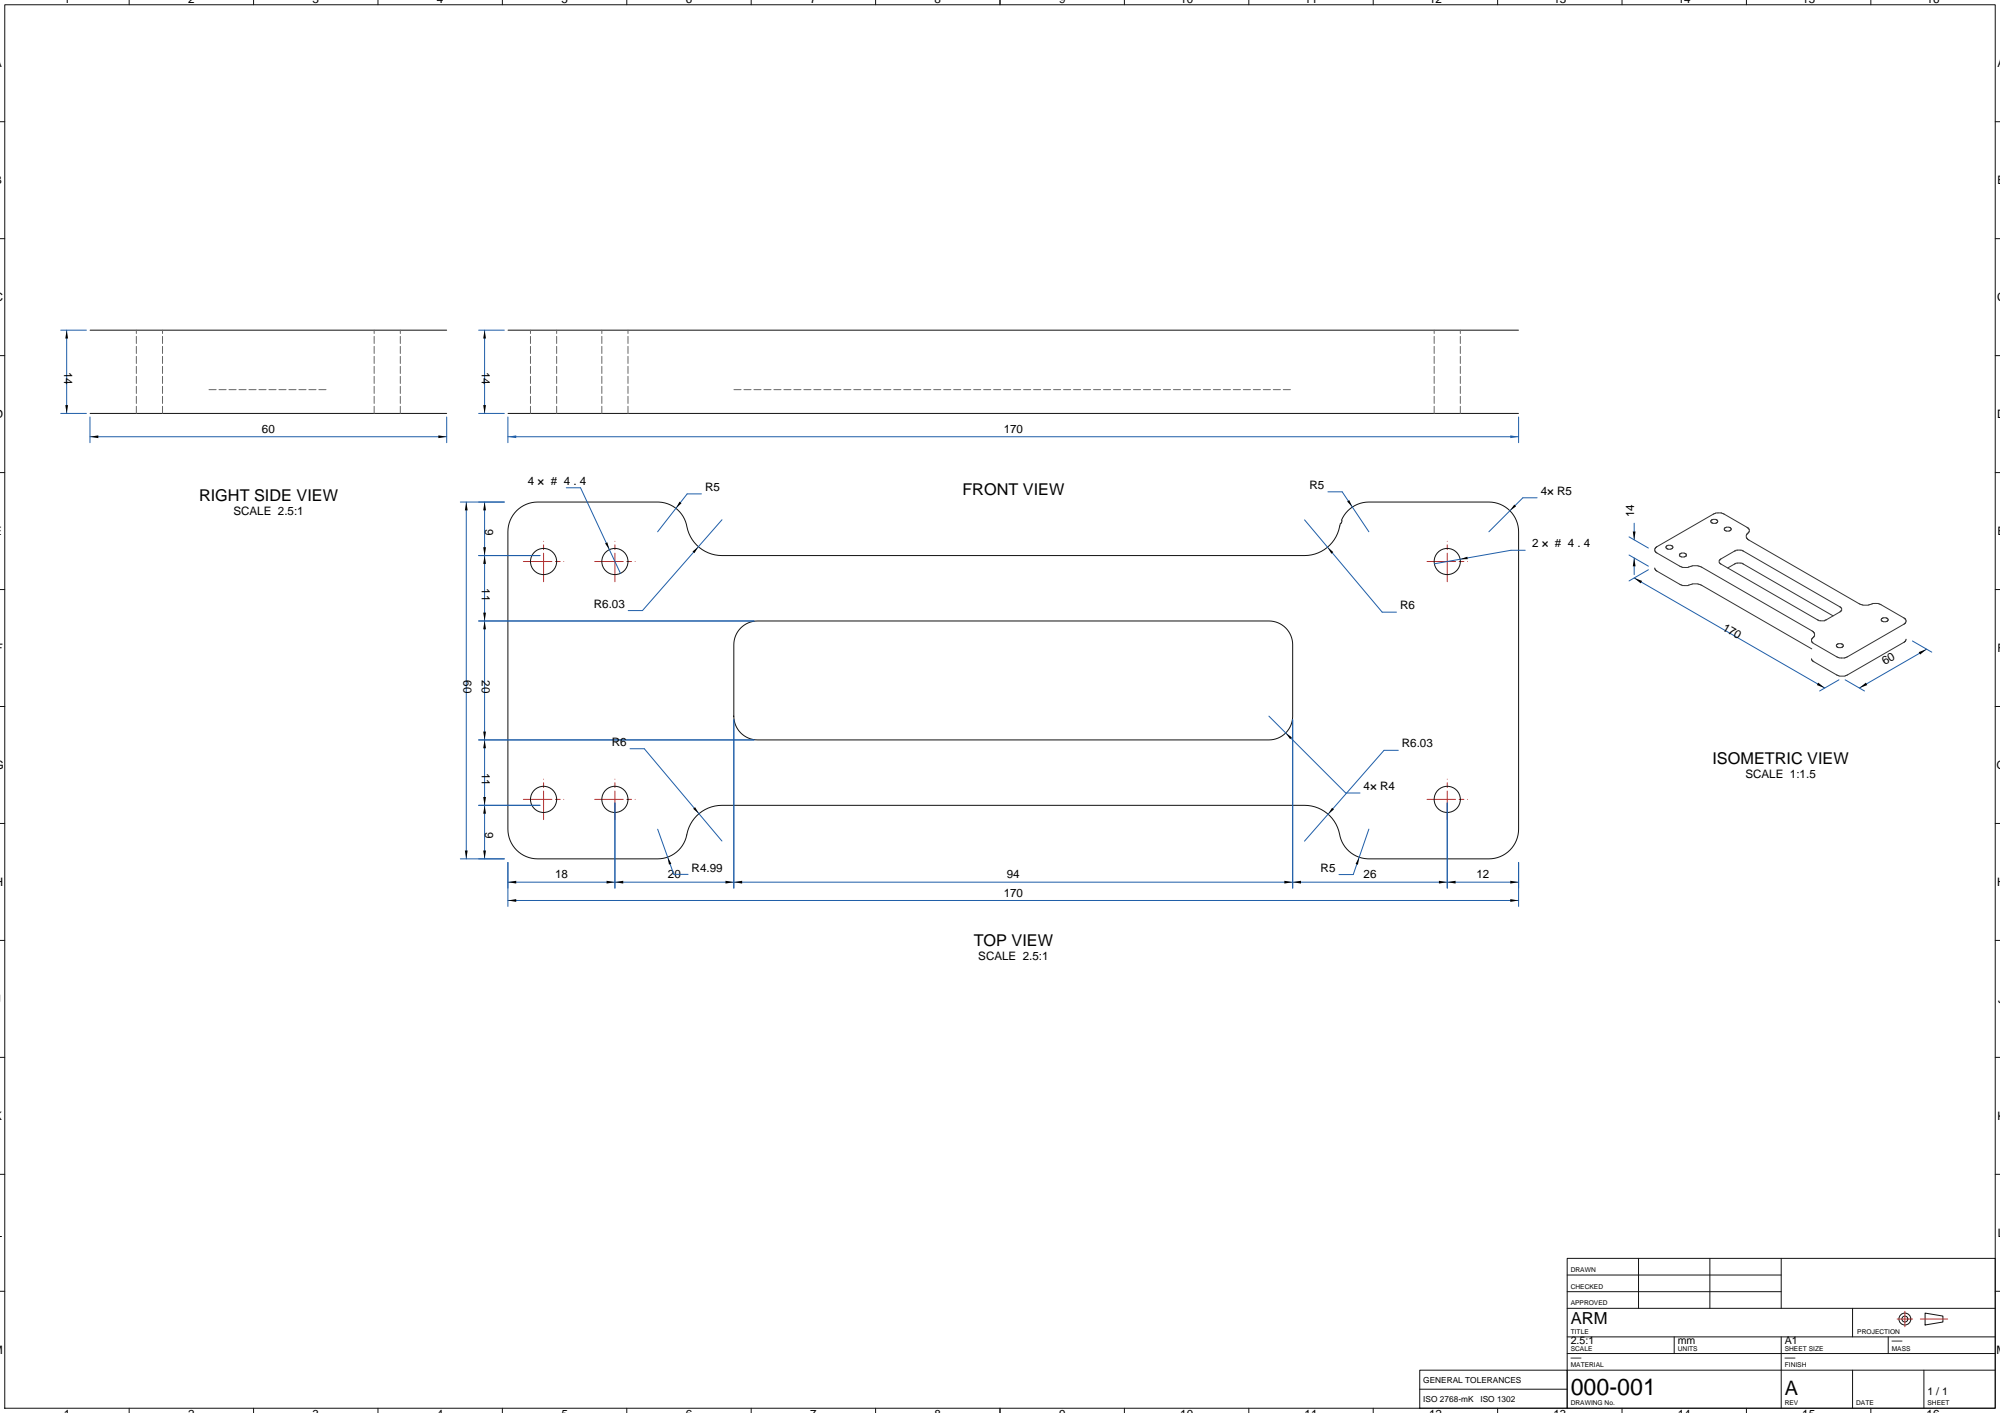
[picture p63: page 1]
