FelipeSorrilha/Desenvolvimento-de-uma-plataforma-experimental/3D models/2D/centralhubv2.pdf

## FRONT VIEW RIGHT SIDE VIEW

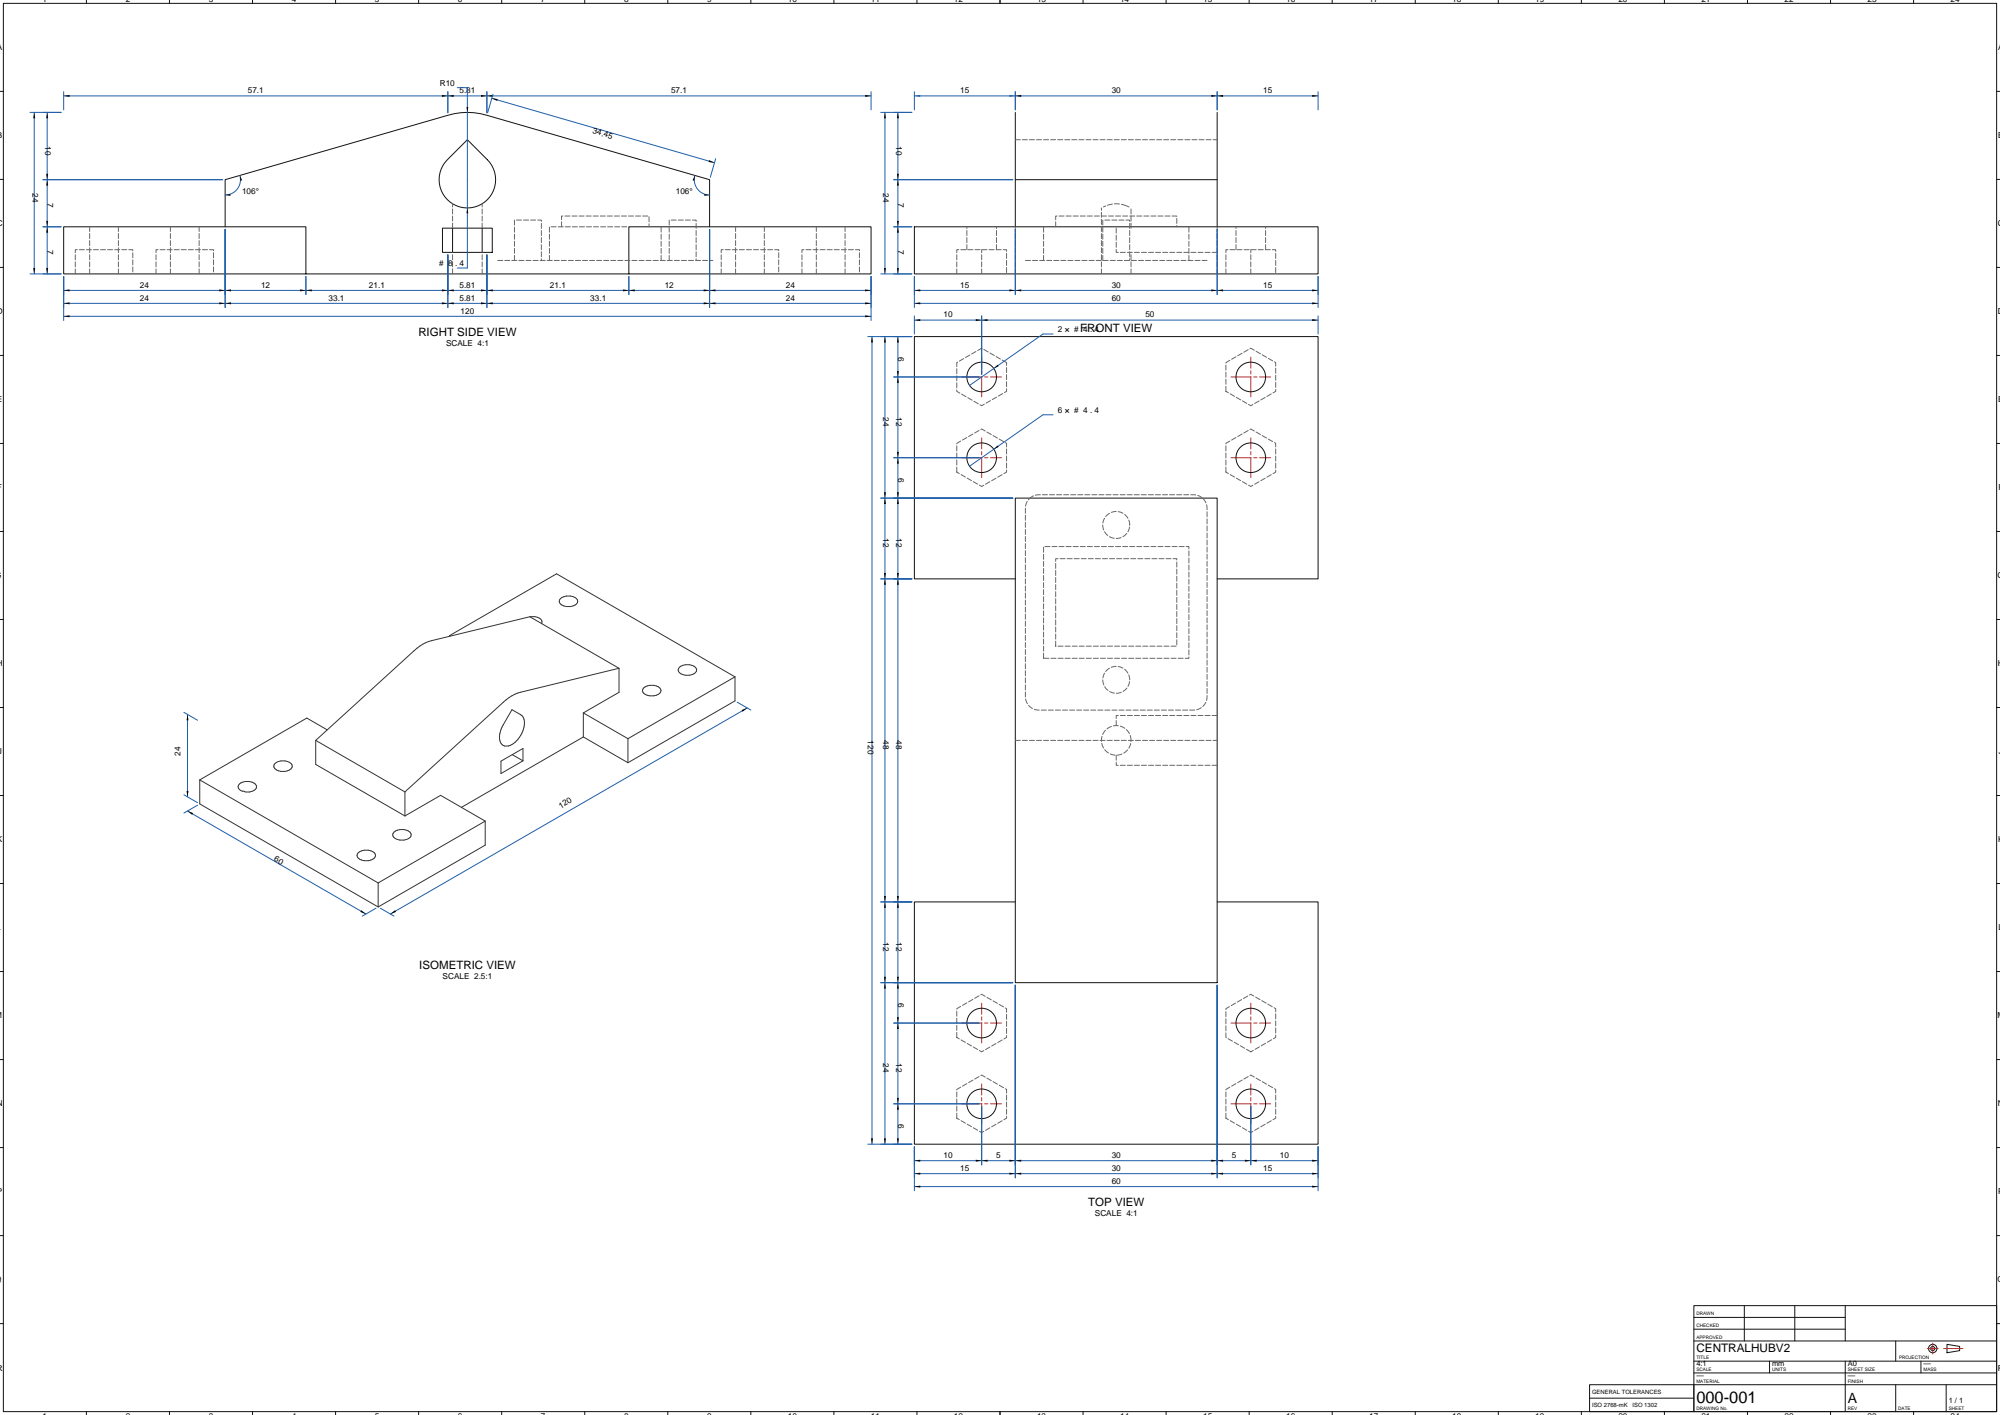
[picture p64: page 1]
