FelipeSorrilha/Desenvolvimento-de-uma-plataforma-experimental/3D models/2D/encaixe-arm-motordrone.pdf

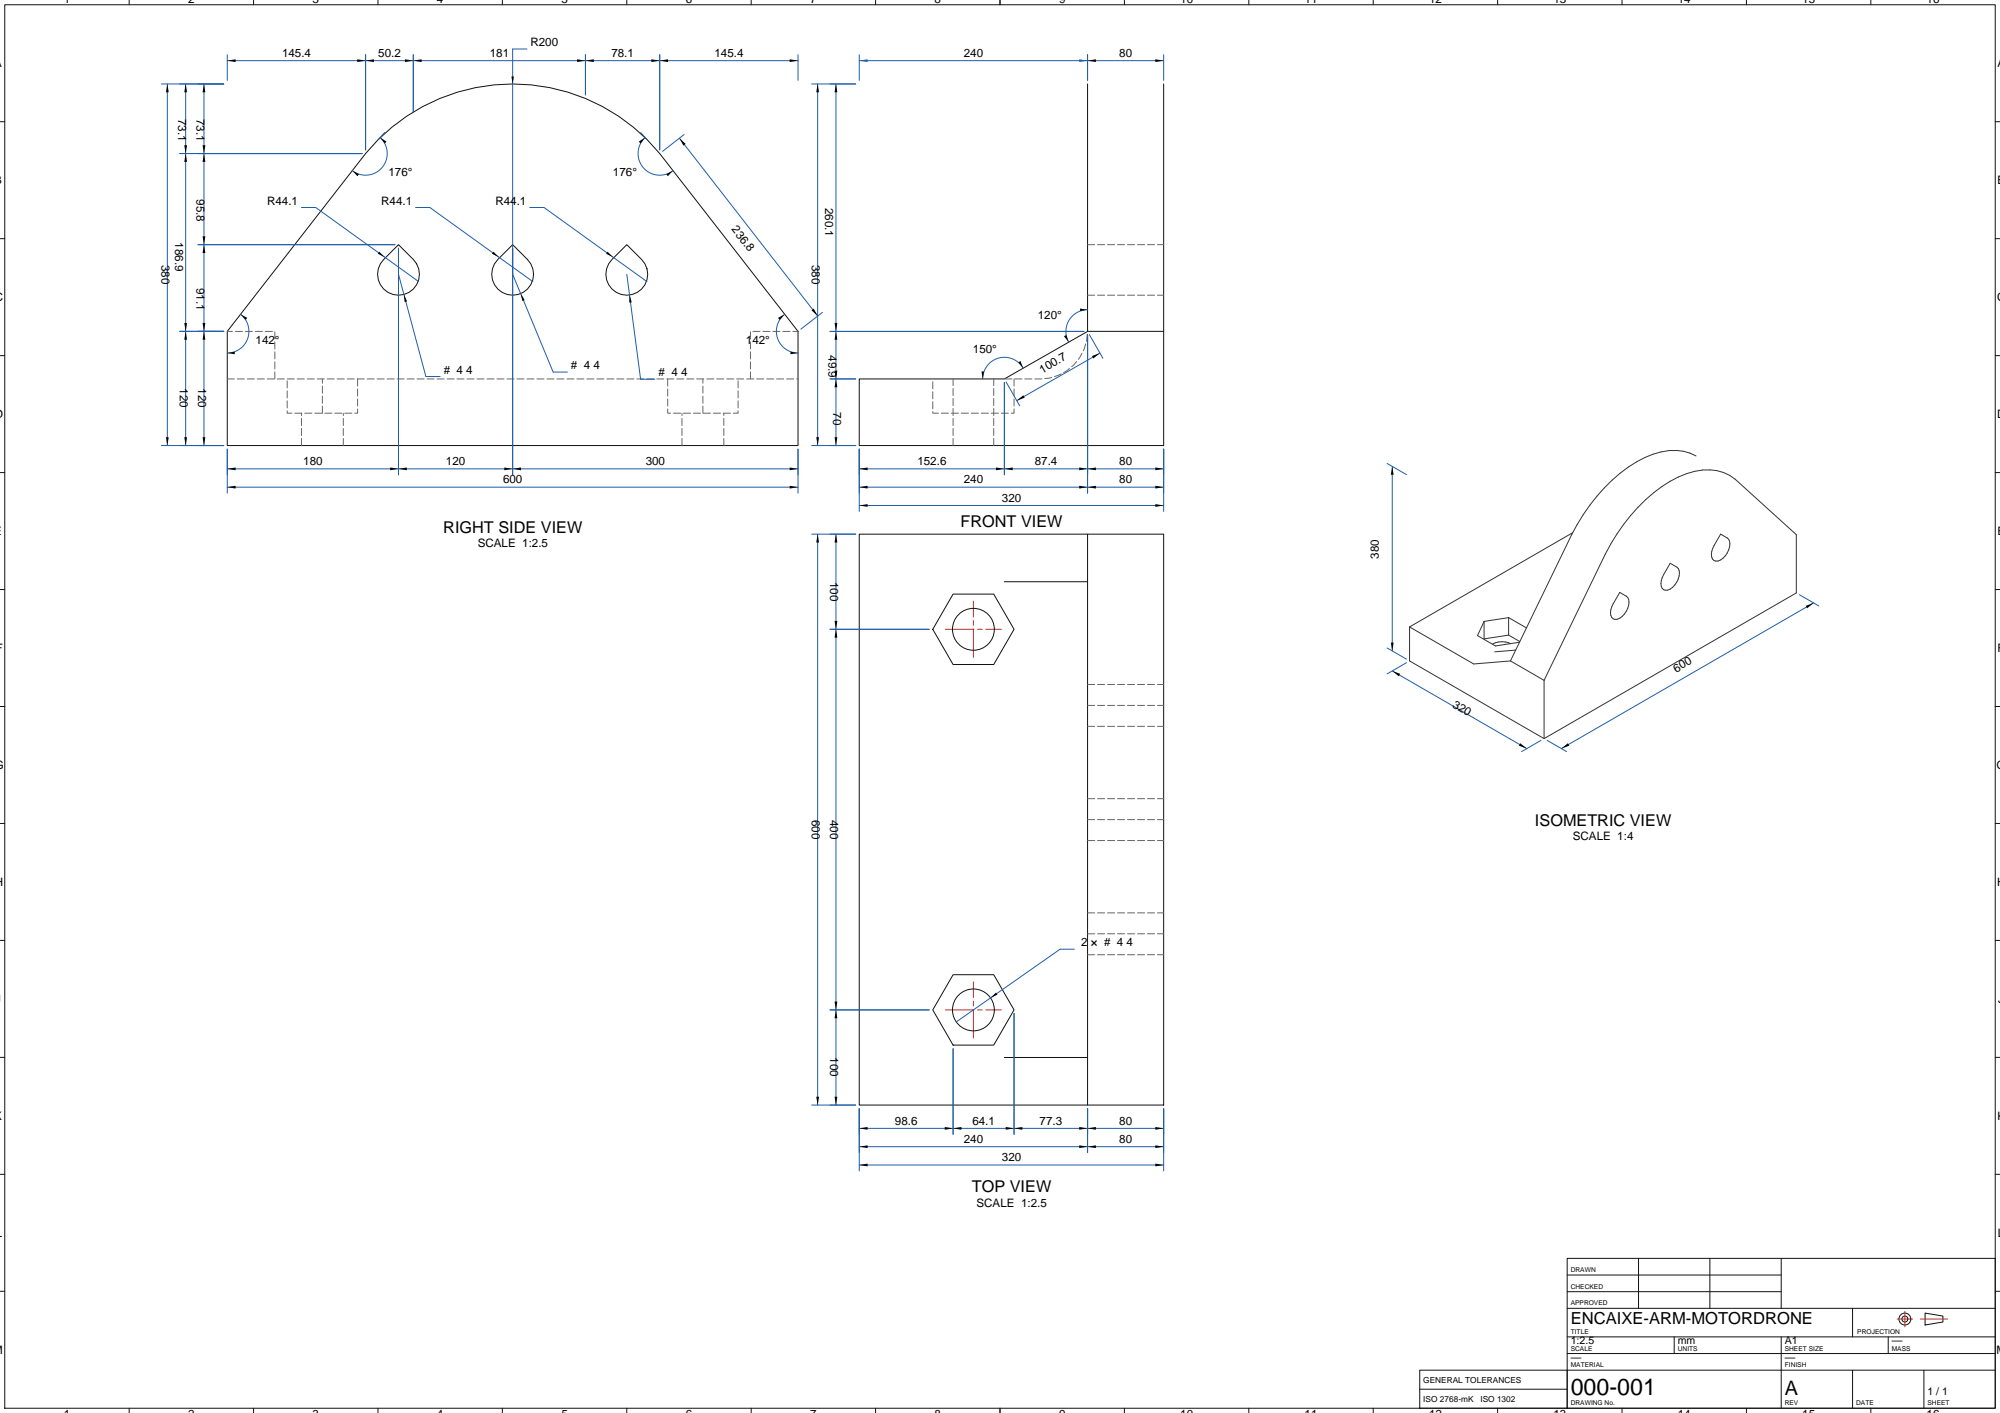
[picture p65: page 1]
