FelipeSorrilha/Desenvolvimento-de-uma-plataforma-experimental/3D models/2D/suporte-motor-drone.pdf

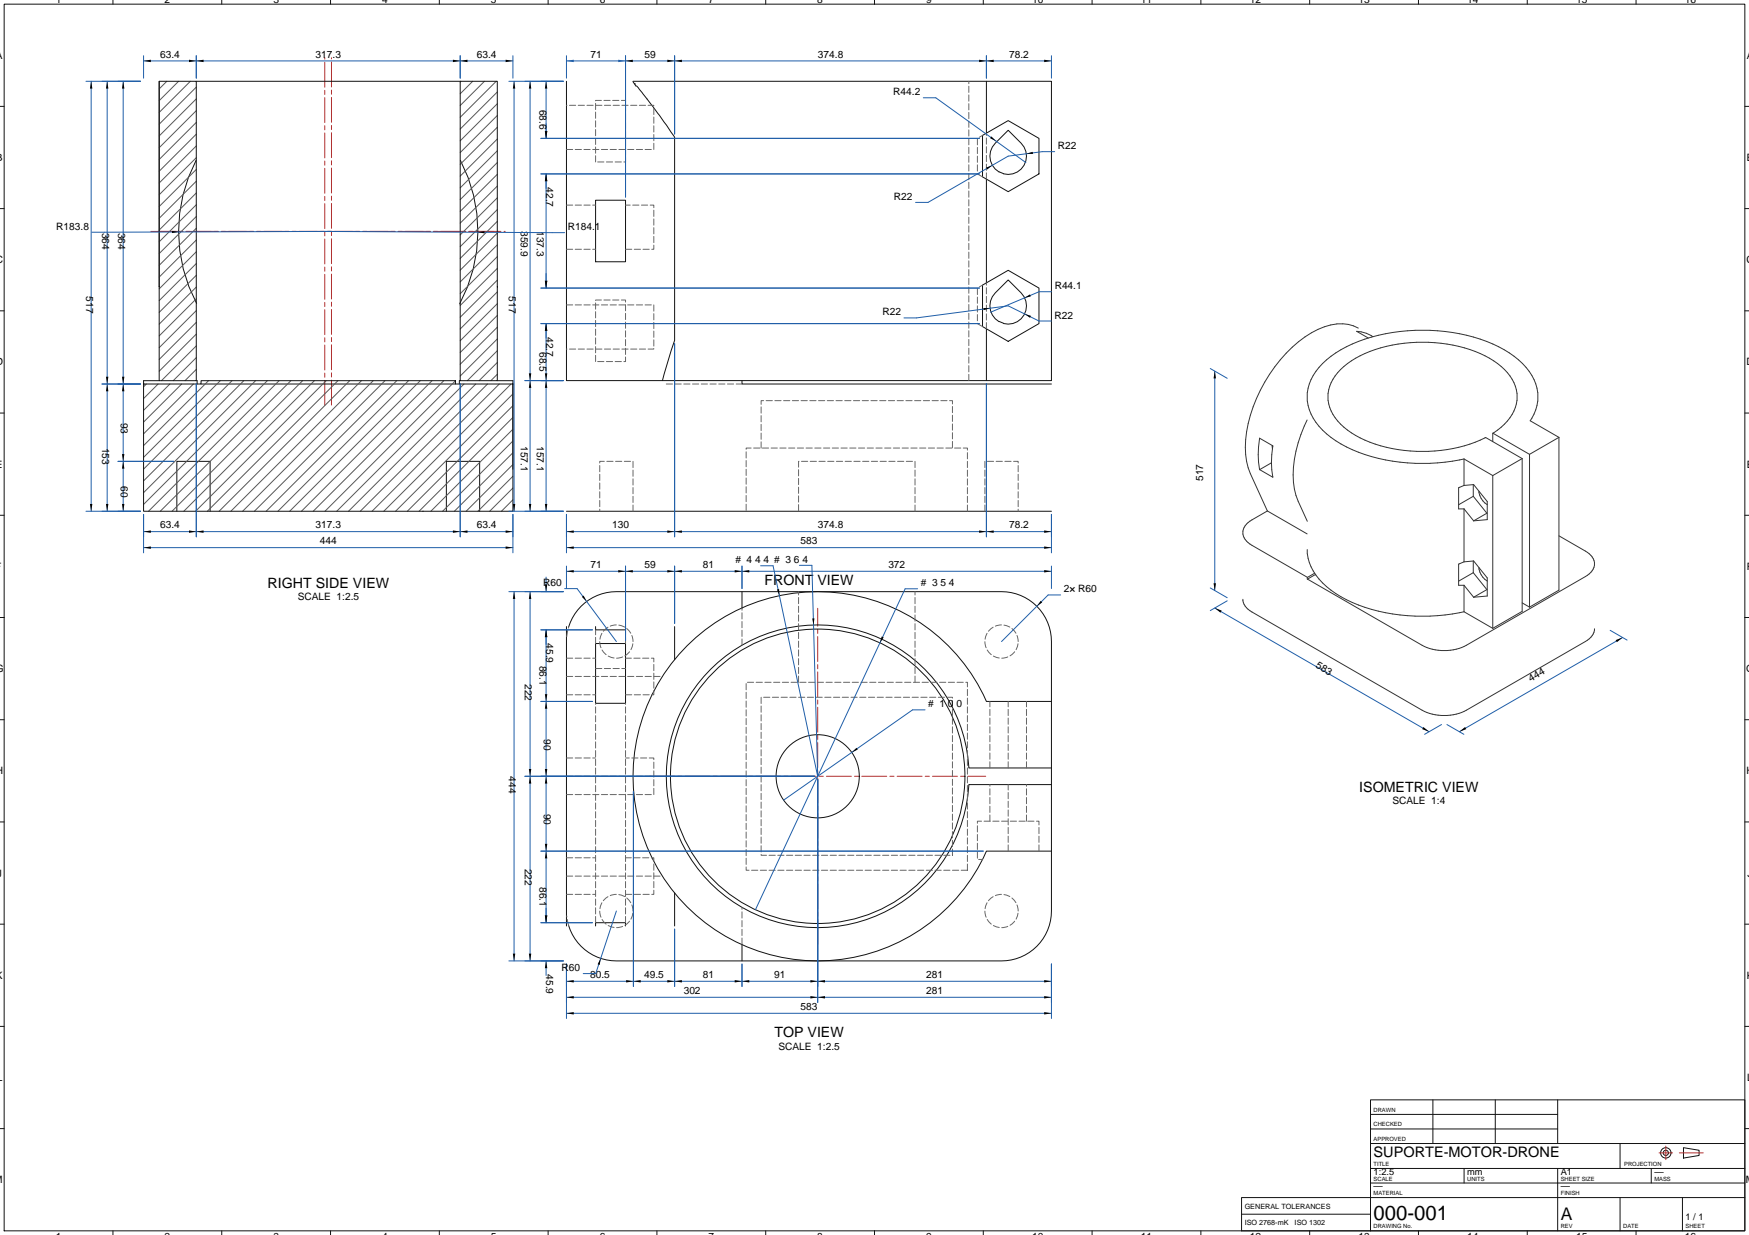
[picture p66: page 1]
