FelipeSorrilha/Desenvolvimento-de-uma-plataforma-experimental/3D models/2D/tampa-motor-drone.pdf

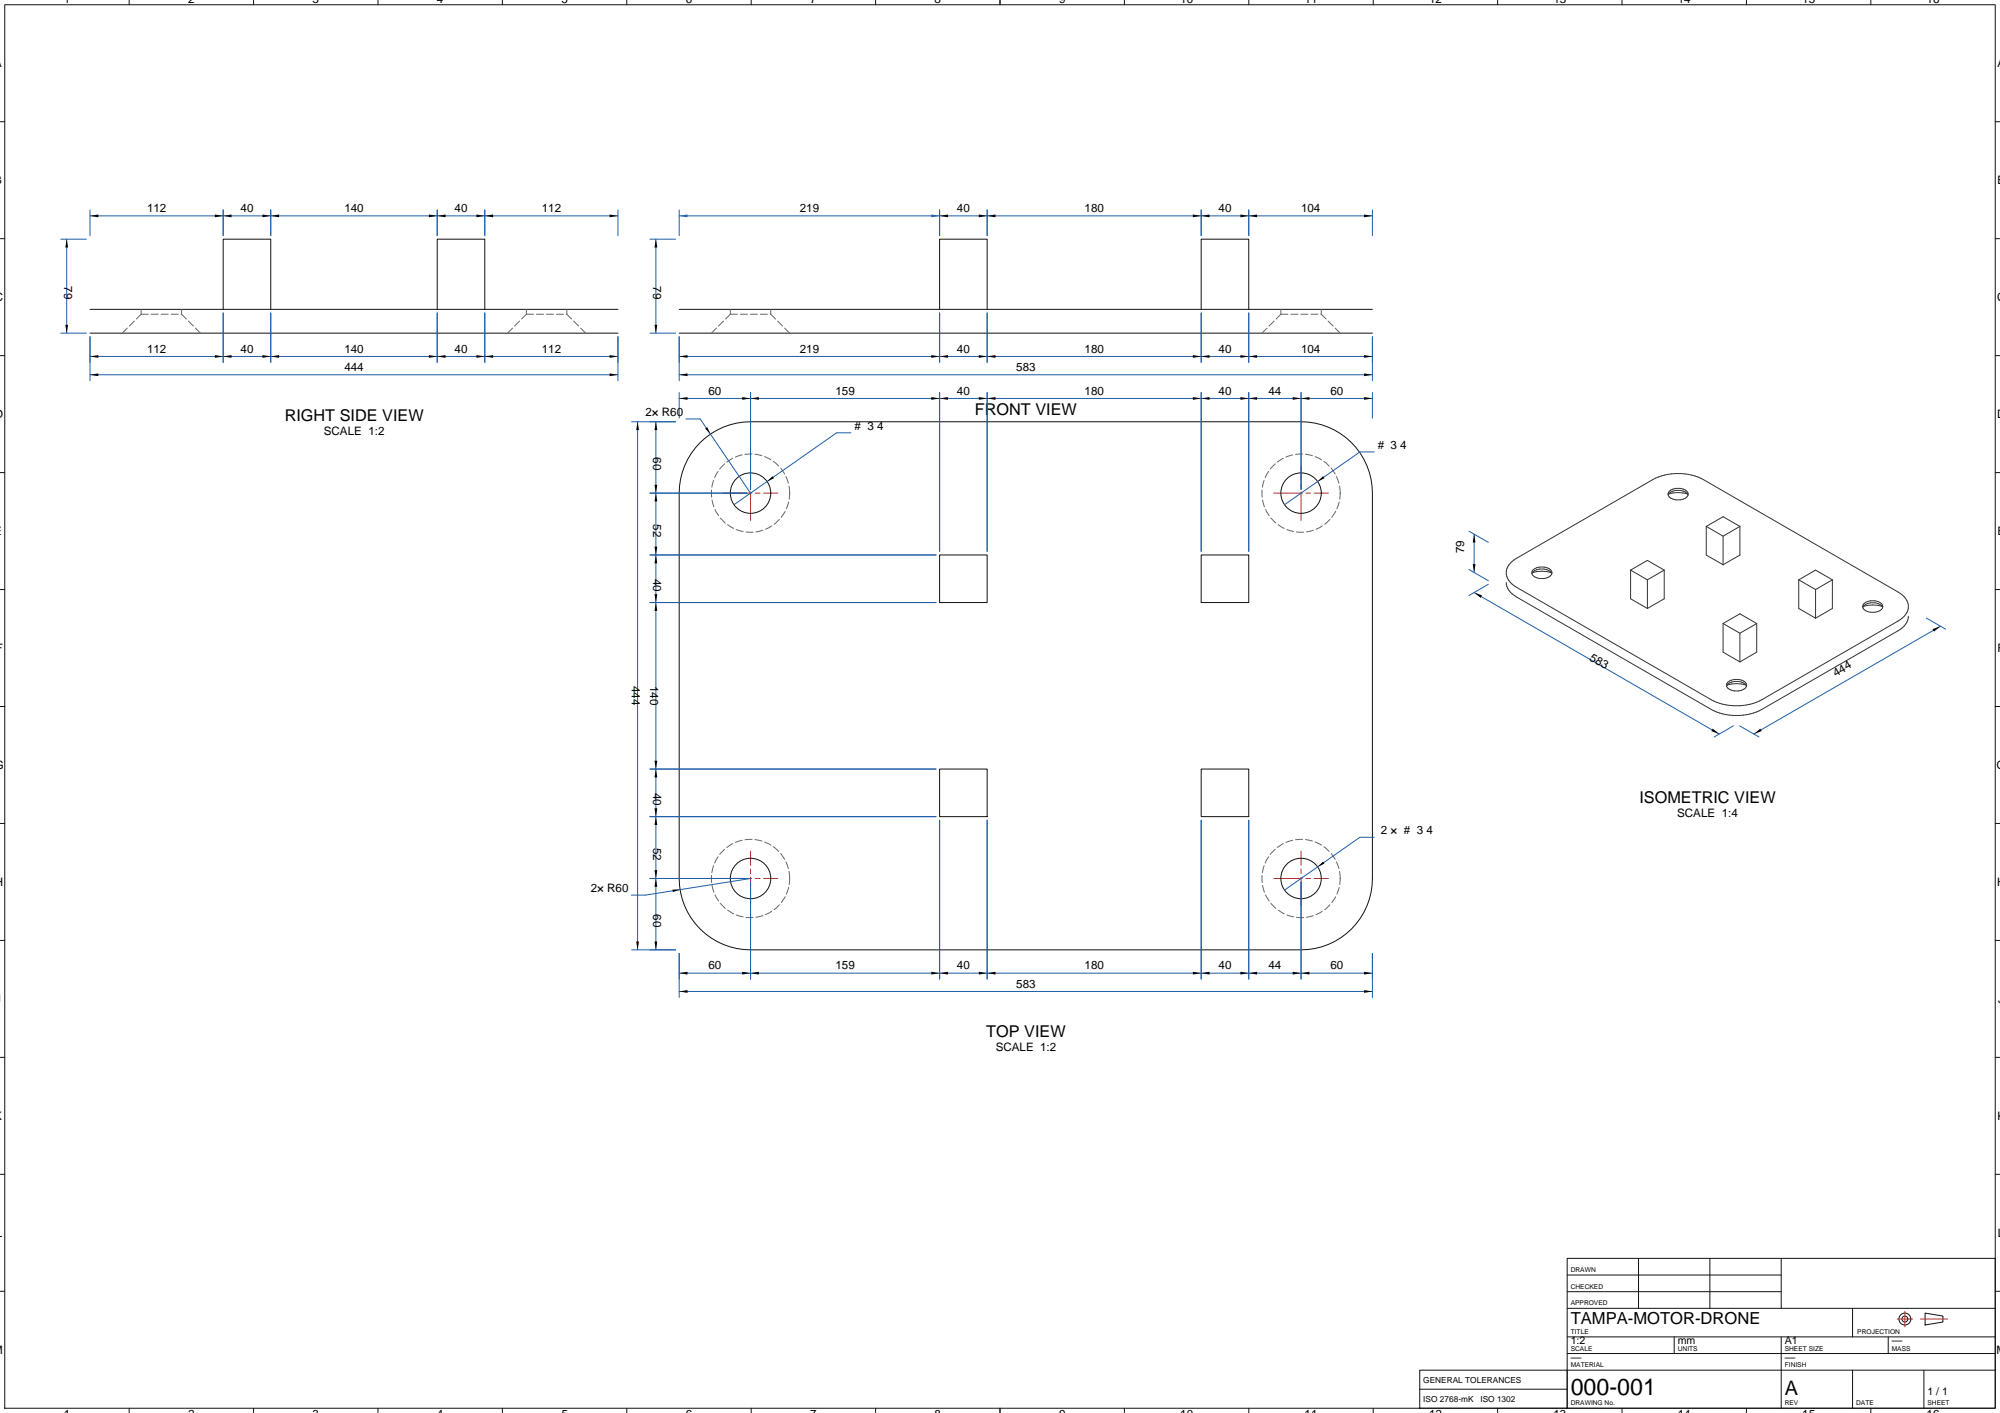
[picture p67: page 1]
