FelipeSorrilha/Desenvolvimento-de-uma-plataforma-experimental/3D models/2D/tampaCentralHub.pdf

## FRONT VIEW RIGHT SIDE VIEW

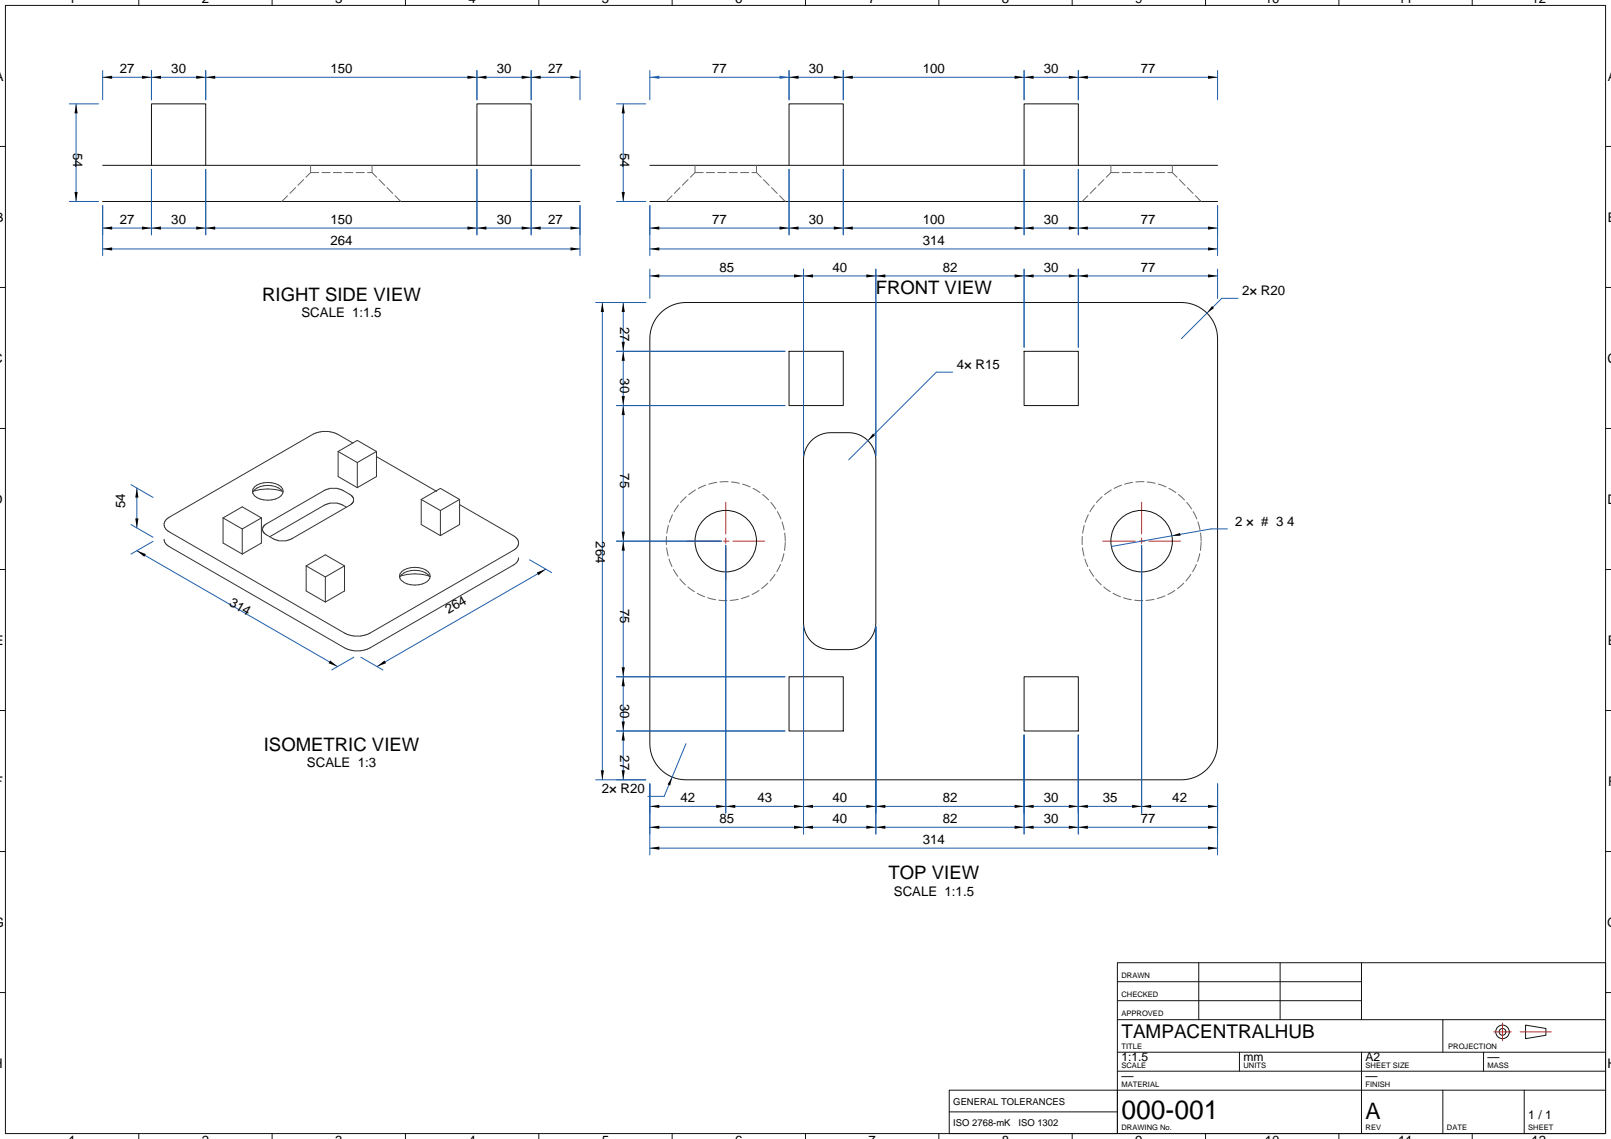
[picture p68: page 1]
