FelipeSorrilha/Desenvolvimento-de-uma-plataforma-experimental/(commit log)

2026-10-15 primeiros modelos 3D adicionados
    [arm.stl, centralhubv2.stl, encaixe-arm-motordrone.stl, suporte-motor-drone.stl, tampa-motor-drone.stl, tampaCentralHub.stl]
2026-10-15 agora tem todos os STLs da parte de cima
    muito provavelmente vou precisar corrigir o novoTopo
    [eixoRolamentosEncoders.stl, novoTopo.stl, tampaNovoTopo.stl, y1.stl, y2.stl]
2026-10-20 modelos 3d atualizados
    [RolamentoOldham-yaw.stl, caixav3.stl, entreOsOldham.stl, oldham1.stl, oldham2.stl, parede-removivel.stl, tampa-solo.stl, y1v2.stl]
2026-10-20 y1 atualizado
    [y1.stl]
2026-10-20 y2 atualizado
    [y2.stl]
2026-10-20 imagens que faltavam da montagem
2026-10-20 mais STLs adicionados
    [helice.stl, rolamentoToY.stl]
2026-10-27 Início da montagem da plataforma no matlab
    [RolamentoOldham-yaw.stl, arm.stl, caixav3.stl, centralhubv2.stl, eixoRolamentosEncoders.stl, encaixe-arm-motordrone.stl, entreOsOldham.stl, helice.stl]
